danhmanu/PLC-STM32F407VET6/kicad/fab/render_bottom.png

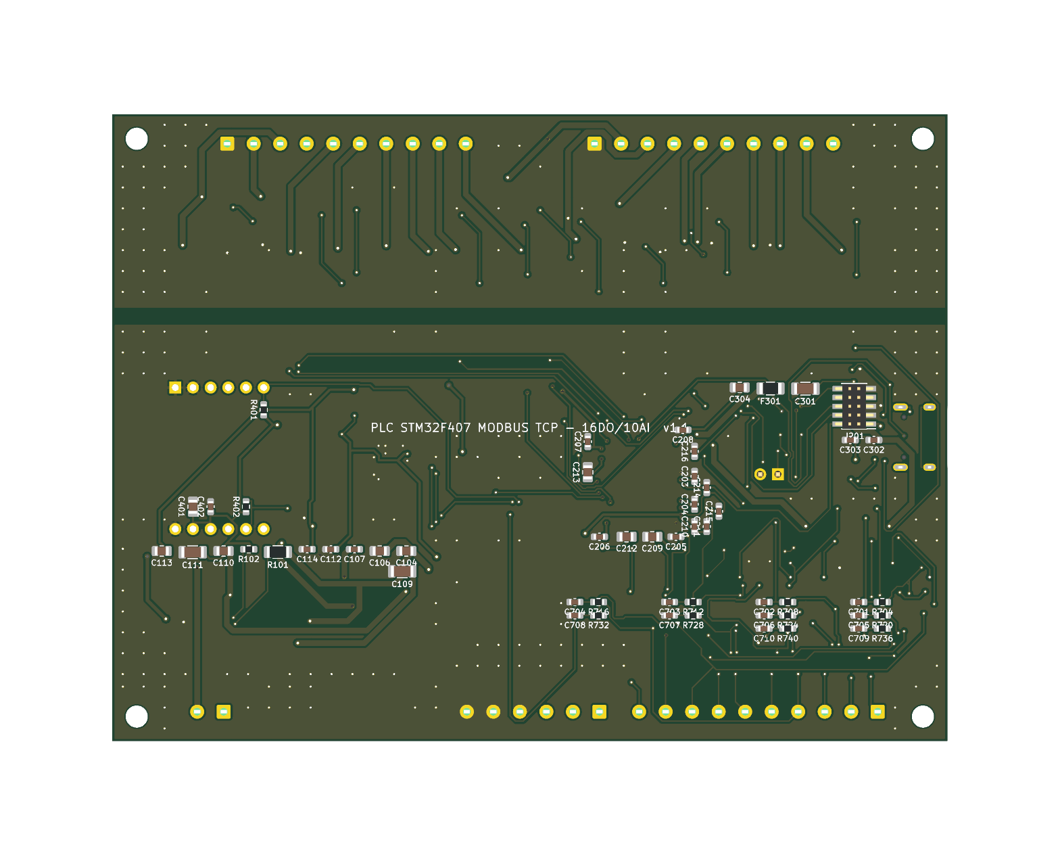
kicad/fab/render_bottom.png
