danhmanu/PLC-STM32F407VET6/kicad/BOM.csv

Ref | Value | Footprint | Qty
C101 | 47uF/50V | Capacitor_SMD:CP_Elec_6.3x7.7 | 1
C102 | 1uF/50V | Capacitor_SMD:C_1206_3216Metric | 1
C103 | 10uF/50V | Capacitor_SMD:C_1210_3225Metric | 1
C104,C106,C502 | 100nF/50V | Capacitor_SMD:C_0805_2012Metric | 3
C105 | 2.2uF/50V | Capacitor_SMD:C_1206_3216Metric | 1
C107,C112,C114,C203-C208,C211,C215,C216,C303,C402,C701-C710 | 100nF | Capacitor_SMD:C_0603_1608Metric | 24
C108,C109,C111 | 22uF | Capacitor_SMD:C_1206_3216Metric | 3
C110,C113,C304,C401 | 10uF | Capacitor_SMD:C_0805_2012Metric | 4
C201,C202 | 20pF | Capacitor_SMD:C_0603_1608Metric | 2
C209 | 4.7uF | Capacitor_SMD:C_0805_2012Metric | 1
C210,C214,C302 | 1uF | Capacitor_SMD:C_0603_1608Metric | 3
C212,C213 | 2.2uF | Capacitor_SMD:C_0805_2012Metric | 2
C301 | 4.7nF/250V | Capacitor_SMD:C_1206_3216Metric | 1
C501 | 10uF/50V | Capacitor_SMD:C_1206_3216Metric | 1
D101 | SS110 (100V/1A) | Diode_SMD:D_SMA | 1
D102 | SMBJ33CA | Diode_SMD:D_SMB | 1
D103 | PWR (green) | LED_SMD:LED_0603_1608Metric | 1
D104 | SS16 | Diode_SMD:D_SMA | 1
D105,D106 | SS14 | Diode_SMD:D_SMA | 2
D107 | 3V3 (green) | LED_SMD:LED_0603_1608Metric | 1
D201 | RUN (green) | LED_SMD:LED_0603_1608Metric | 1
D202 | ERR (red) | LED_SMD:LED_0603_1608Metric | 1
D501,D503,D505,D507,D509,D511,D513,D515,D517,D519,D521,D523,D525,D527,D529,D531 | SS16FL | Diode_SMD:D_SOD-123F | 16
D502 | Q1 | LED_SMD:LED_0603_1608Metric | 1
D504 | Q2 | LED_SMD:LED_0603_1608Metric | 1
D506 | Q3 | LED_SMD:LED_0603_1608Metric | 1
D508 | Q4 | LED_SMD:LED_0603_1608Metric | 1
D510 | Q5 | LED_SMD:LED_0603_1608Metric | 1
D512 | Q6 | LED_SMD:LED_0603_1608Metric | 1
D514 | Q7 | LED_SMD:LED_0603_1608Metric | 1
D516 | Q8 | LED_SMD:LED_0603_1608Metric | 1
D518 | Q9 | LED_SMD:LED_0603_1608Metric | 1
D520 | Q10 | LED_SMD:LED_0603_1608Metric | 1
D522 | Q11 | LED_SMD:LED_0603_1608Metric | 1
D524 | Q12 | LED_SMD:LED_0603_1608Metric | 1
D526 | Q13 | LED_SMD:LED_0603_1608Metric | 1
D528 | Q14 | LED_SMD:LED_0603_1608Metric | 1
D530 | Q15 | LED_SMD:LED_0603_1608Metric | 1
D532 | Q16 | LED_SMD:LED_0603_1608Metric | 1
D533 | SMBJ33A | Diode_SMD:D_SMB | 1
D701-D710 | SMF5.0CA | Diode_SMD:D_SOD-123F | 10
F101 | PTC MF-MSMF050-2 0.5A/60V | Fuse:Fuse_1812_4532Metric | 1
F301 | 500mA | Fuse:Fuse_1206_3216Metric | 1
F711 | MF-MSMF050-2 0.5A/60V | Fuse:Fuse_1812_4532Metric | 1
FB101 | BLM31PG601SN1 3A | Inductor_SMD:L_1206_3216Metric | 1
FB102 | 600R@100MHz | Inductor_SMD:L_0805_2012Metric | 1
J101 | 24VDC IN | TerminalBlock_Phoenix:TerminalBlock_Phoenix_MKDS-1-2-3.81_1x02_P3.81mm_Horizontal | 1
J201 | SWD | Connector_PinHeader_1.27mm:PinHeader_2x05_P1.27mm_Vertical_SMD | 1
J301 | USB-C | Connector_USB:USB_C_Receptacle_GCT_USB4105-xx-A_16P_TopMnt_Horizontal | 1
J401 | W5500 Lite module | PLC:W5500_Lite_Module | 1
J501 | OUT 1-8 | TerminalBlock_Phoenix:TerminalBlock_Phoenix_MKDS-1-10-3.81_1x10_P3.81mm_Horizontal | 1
J502 | OUT 9-16 | TerminalBlock_Phoenix:TerminalBlock_Phoenix_MKDS-1-10-3.81_1x10_P3.81mm_Horizontal | 1
J701 | AI 1-10 (4-20mA) | TerminalBlock_Phoenix:TerminalBlock_Phoenix_MKDS-1-10-3.81_1x10_P3.81mm_Horizontal | 1
J703 | AI PWR/COM | TerminalBlock_Phoenix:TerminalBlock_Phoenix_MKDS-1-6-3.81_1x06_P3.81mm_Horizontal | 1
JP301 | AUTO-BOOT | Connector_PinHeader_2.54mm:PinHeader_1x02_P2.54mm_Vertical | 1
L101 | CMC TDK ACM7060-701-2PL | Inductor_SMD:L_CommonModeChoke_TDK_ACM7060 | 1
L102 | 10uH 1A | Inductor_SMD:L_Bourns-SRN4018 | 1
Q301,Q302 | MMBT3904 | Package_TO_SOT_SMD:SOT-23 | 2
Q303 | MMBT3906 | Package_TO_SOT_SMD:SOT-23 | 1
Q501-Q516 | DMN6075S | Package_TO_SOT_SMD:SOT-23 | 16
R101 | 4.7k | Resistor_SMD:R_1206_3216Metric | 1
R102,R203,R204,R308 | 1k | Resistor_SMD:R_0603_1608Metric | 4
R201,R202,R304-R307,R401,R402,R502-R504,R506-R508,R510-R512,R514-R516,R518-R520,R522-R524,R526-R528,R530-R532,R534-R536,R538-R540,R542-R544,R546-R548,R550-R552,R554-R556,R558-R560,R562-R564 | 10k | Resistor_SMD:R_0603_1608Metric | 56
R301,R302 | 5.1k | Resistor_SMD:R_0603_1608Metric | 2
R303 | 1M | Resistor_SMD:R_0603_1608Metric | 1
R501,R505,R509,R513,R517,R521,R525,R529,R533,R537,R541,R545,R549,R553,R557,R561 | 470 | Resistor_SMD:R_0603_1608Metric | 16
R701,R705,R709,R713,R717,R721,R725,R729,R733,R737 | 120 0.1% 25ppm | Resistor_SMD:R_1206_3216Metric | 10
R704,R708,R712,R716,R720,R724,R728,R732,R736,R740 | 4.7k | Resistor_SMD:R_0603_1608Metric | 10
SW201 | RESET | Button_Switch_SMD:SW_SPST_PTS810 | 1
SW202 | BOOT | Button_Switch_SMD:SW_SPST_PTS810 | 1
U101 | LMR16006YQ5 | Package_TO_SOT_SMD:SOT-23-6 | 1
U102 | AMS1117-3.3 | Package_TO_SOT_SMD:SOT-223-3_TabPin2 | 1
U200 | STM32F407VET6 | Package_QFP:LQFP-100_14x14mm_P0.5mm | 1
U201 | REF3030 | Package_TO_SOT_SMD:SOT-23 | 1
U301 | USBLC6-2SC6 | Package_TO_SOT_SMD:SOT-23-6 | 1
U302 | CH340C | Package_SO:SOIC-16_3.9x9.9mm_P1.27mm | 1
U501-U516 | PC817 (SMD) | Package_DIP:SMDIP-4_W9.53mm | 16
Y201 | 8MHz 20pF | Crystal:Crystal_SMD_3225-4Pin_3.2x2.5mm | 1
