danhmanu/PLC-STM32F407VET6/kicad/PLC_STM32_Modbus.pdf

1 | 2 | 3 | 4 | 5 | 6 | 7 | 8

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
Size: A3 | Rev: 1.0 | F Date: 2026-10-14
KiCad E.D.A. 10.0.6 | Id: 1/7

# Title: PLC STM32F407 Modbus TCP - 16DO / 10AI

## File: PLC_STM32_Modbus.kicad_sch

## Sheet: /

## PLC STM32F407 + W5500 Modbus TCP

## Sheet: Root

## 16 ngo ra transistor File: outputs.kicad_sch

## Nguon 24VDC

## File: power.kicad_sch

## MCU STM32F407VET6

File: mcu.kicad_sch | USB nap code
File: usb.kicad_sch | Ethernet File: comm.kicad_sch 10 ngo vao analog

## File: analog.kicad_sch

# PLC STM32F407VET6 + W5500 : Modbus TCP (LAN), nap code qua USB-C (CH340C)

# TỔNG QUAN HỆ THỐNG – PLC STM32F407 + W5500 (Modbus TCP)

- Nguồn 24VDC → bảo vệ (PTC, chống ngược, TVS) + lọc nhiễu → buck 5V → LDO 3.3V; +3.3VA riêng cho ADC. • MCU STM32F407VET6 (168MHz): 16 ngõ ra DO1–DO16, 10 ngõ vào 4–20mA (ADC 12-bit, VREF 3.000V), SPI2 → W5500. • Ethernet: module W5500 Lite (có sẵn RJ45): Modbus TCP cổng 502, tối đa 8 kết nối. Coil 00001–00016 = DO1–DO16; Input Register 30001–30010 = AI1–AI10. • USB-C + CH340C: nạp chương trình qua bootloader UART (tự vào boot bằng DTR/RTS), cổng debug. • 16 ngõ ra: opto PC817 (cách ly 5kV) + MOSFET 60V/2.5A, kiểu sink, nguồn tải V+/COM riêng 12–30V. • 10 ngõ vào 4–20mA: TVS + shunt 120Ω + lọc RC; J703 cấp 24V (PTC 0.5A) nuôi cảm biến 2 dây. • Ghi chú chi tiết (tác dụng, cách tính giá trị) đặt ngay cạnh từng linh kiện ở các trang con.

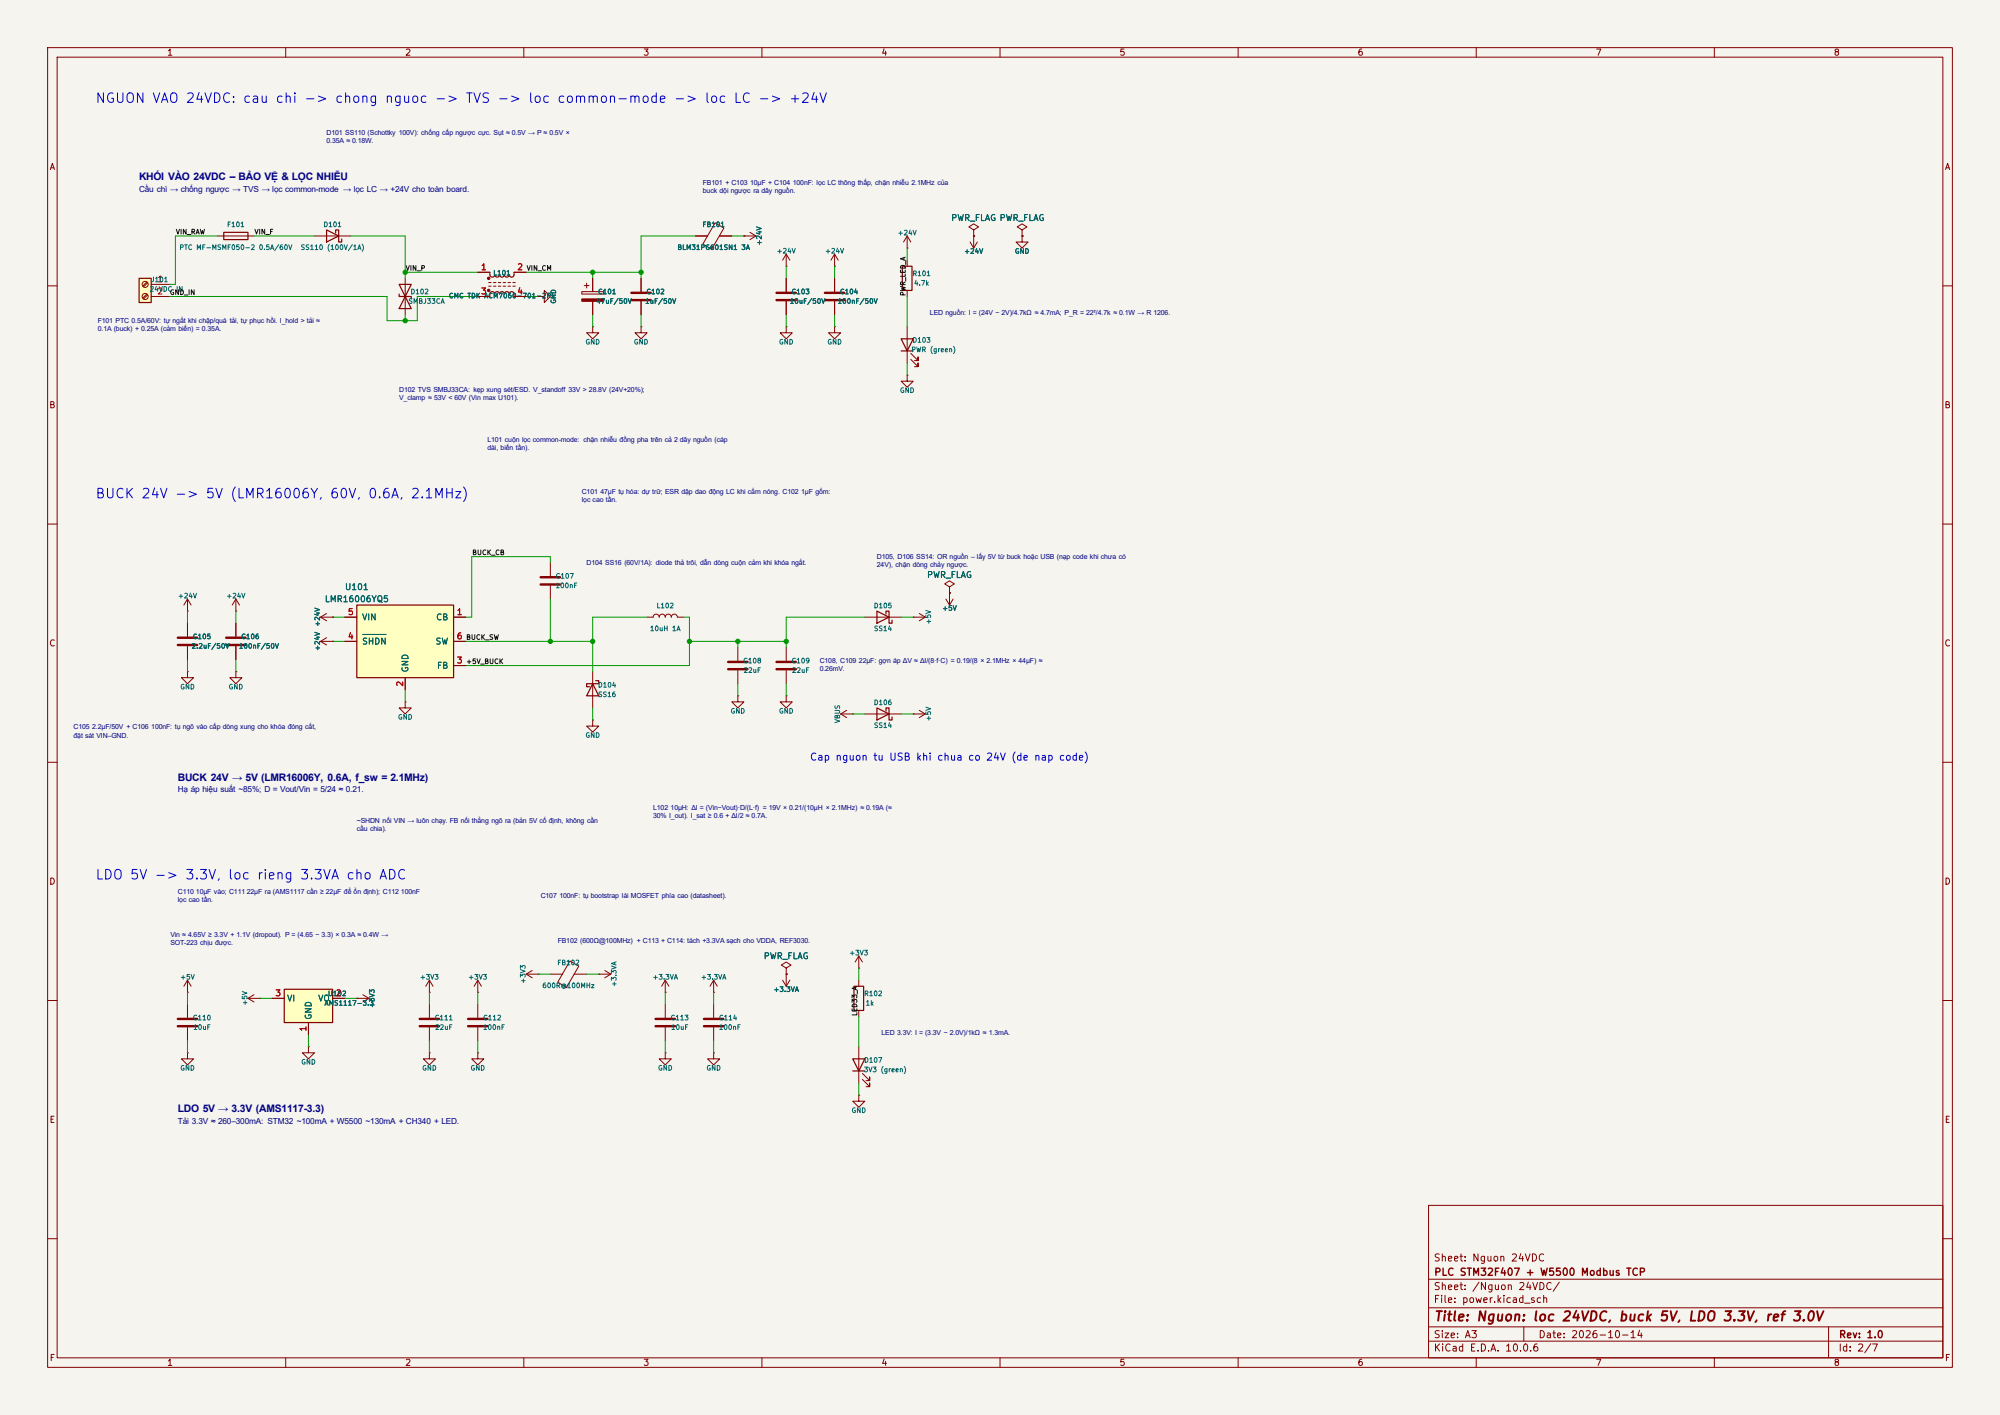
[picture p3: page 2]

NGUON VAO 24VDC: cau chi -> chong nguoc -> TVS -> loc common-mode -> loc LC -> +24V
VIN_RAW

0.35A ≈ 0.18W. F101 PTC 0.5A/60V: tự ngắt khi chập/quá tải, tự phục hồi. I_hold > tải ≈ 0.1A (buck) + 0.25A (cảm biến) = 0.35A.

D101 SS110 (Schottky 100V): chống cấp ngược cực. Sụt ≈ 0.5V → P ≈ 0.5V ×

Cầu chì → chống ngược → TVS → lọc common-mode → lọc LC → +24V cho toàn board. KHỐI VÀO 24VDC – BẢO VỆ & LỌC NHIỄU

FB101 + C103 10µF + C104 100nF: lọc LC thông thấp, chặn nhiễu 2.1MHz của

L101 cuộn lọc common-mode: chặn nhiễu đồng pha trên cả 2 dây nguồn (cáp
dài, biến tần).

lọc cao tần. BUCK 24V -> 5V (LMR16006Y, 60V, 0.6A, 2.1MHz)
lọc cao tần. LDO 5V -> 3.3V, loc rieng 3.3VA cho ADC

L102 10µH: ΔI = (Vin−Vout)·D/(L·f) = 19V × 0.21/(10µH × 2.1MHz) ≈ 0.19A (≈ 30% I_out). I_sat ≥ 0.6 + ΔI/2 ≈ 0.7A.

~SHDN nối VIN → luôn chạy. FB nối thẳng ngõ ra (bản 5V cố định, không cần
cầu chia).

Sheet: Nguon 24VDC
PLC STM32F407 + W5500 Modbus TCP
Sheet: /Nguon 24VDC/
File: power.kicad_sch
Title: Nguon: loc 24VDC, buck 5V, LDO 3.3V, ref 3.0V

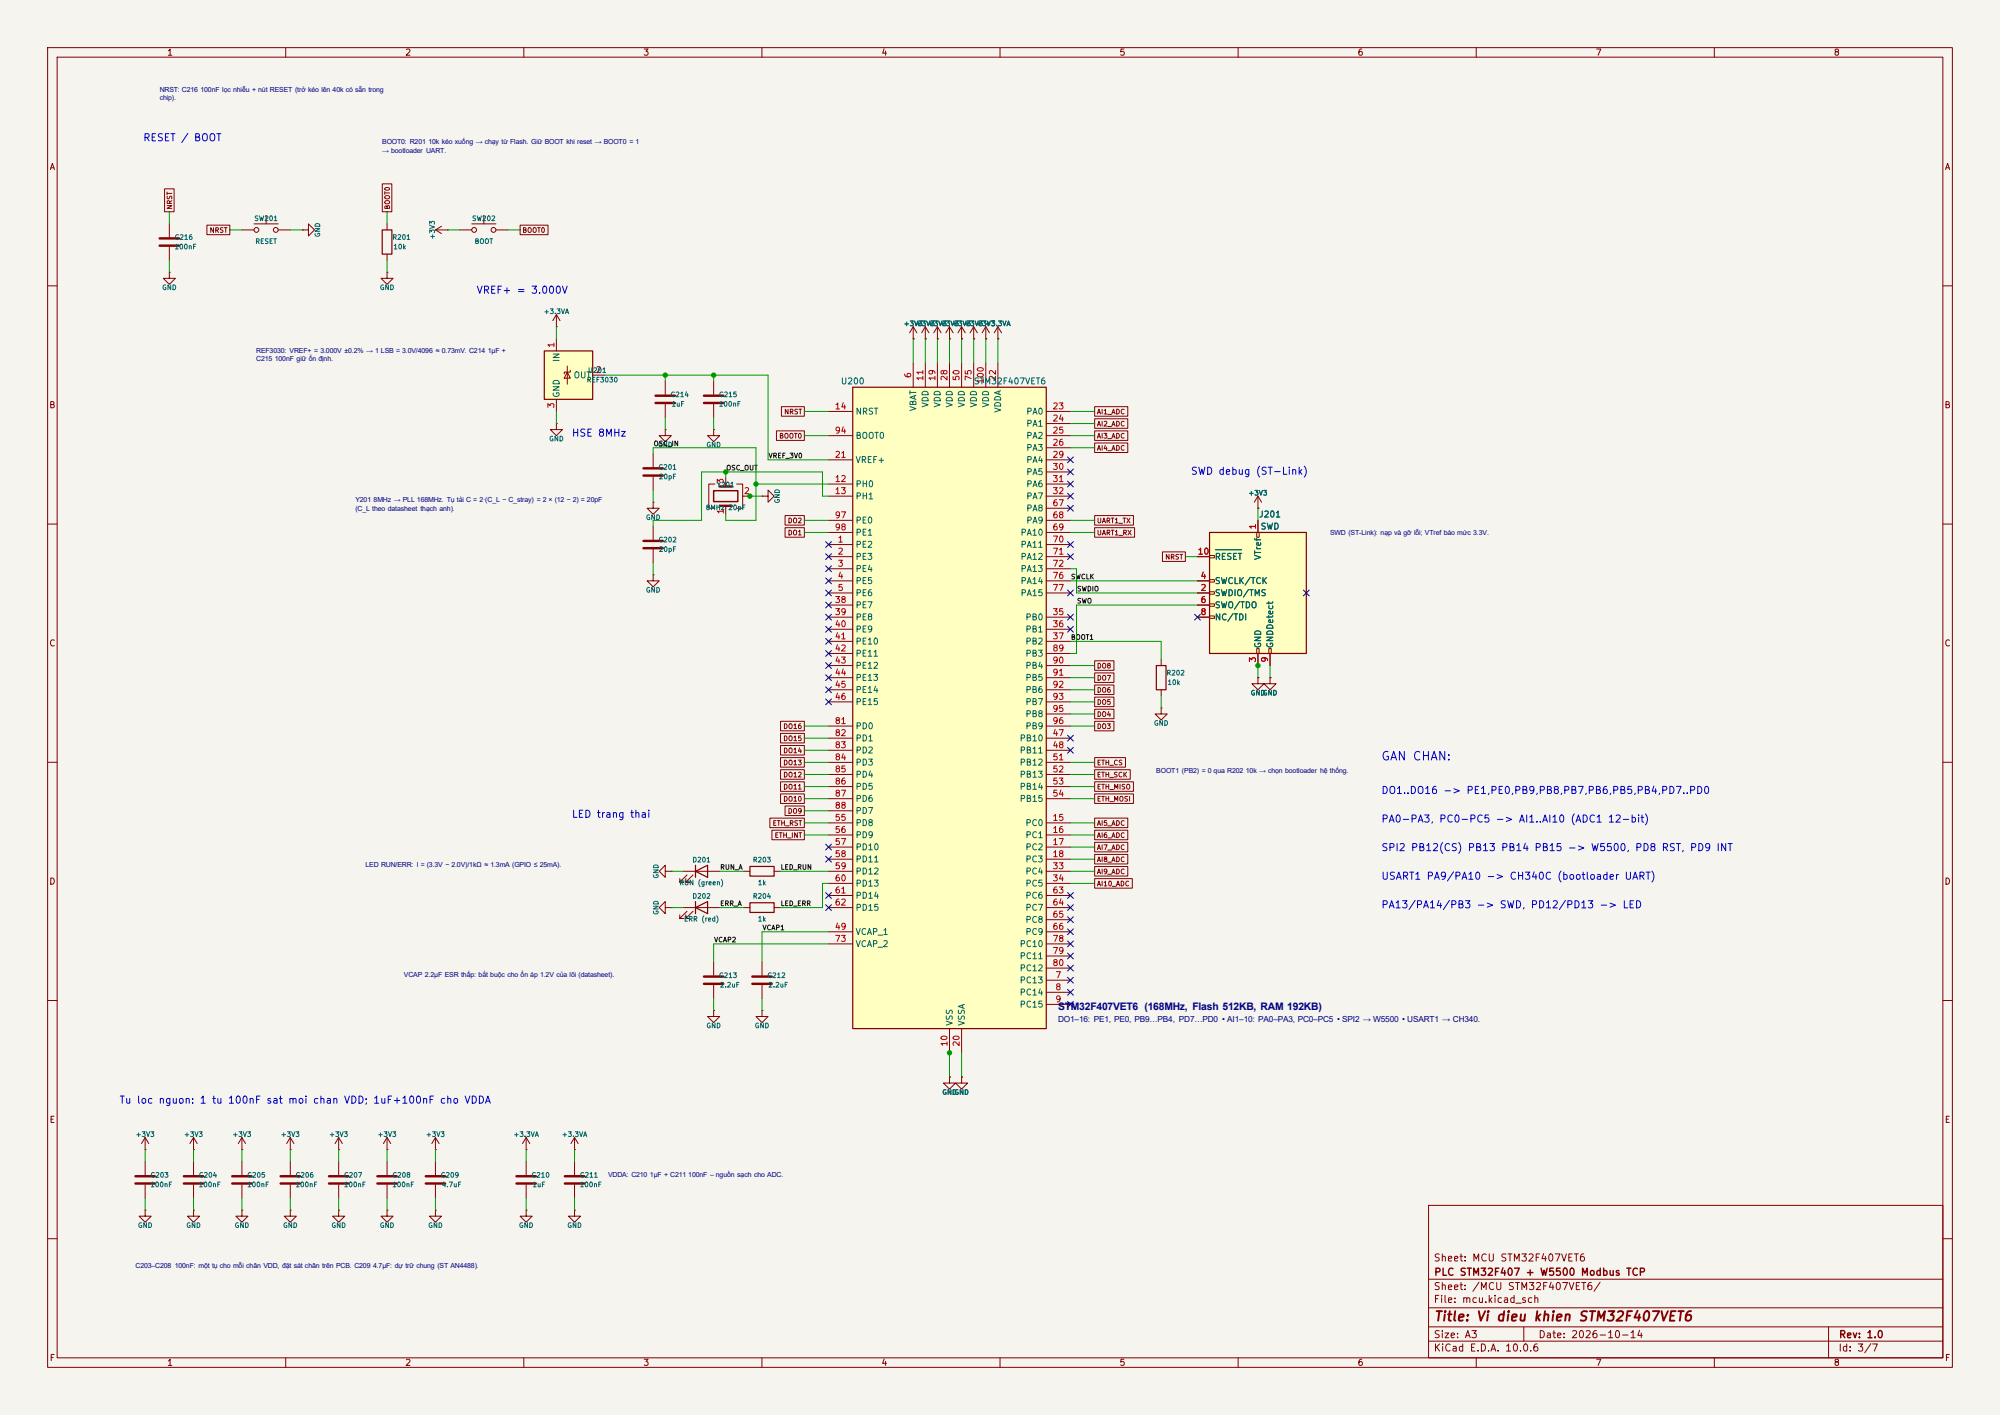
[picture p4: page 3]

NRST: C216 100nF lọc nhiễu + nút RESET (trở kéo lên 40k có sẵn trong

BOOT0: R201 10k kéo xuống → chạy từ Flash. Giữ BOOT khi reset → BOOT0 = 1 → bootloader UART.

Tu loc nguon: 1 tu 100nF sat moi chan VDD; 1uF+100nF cho VDDA

Sheet: MCU STM32F407VET6
PLC STM32F407 + W5500 Modbus TCP
Sheet: /MCU STM32F407VET6/
File: mcu.kicad_sch
Title: Vi dieu khien STM32F407VET6

C203–C208 100nF: một tụ cho mỗi chân VDD, đặt sát chân trên PCB. C209 4.7µF: dự trữ chung (ST AN4488).

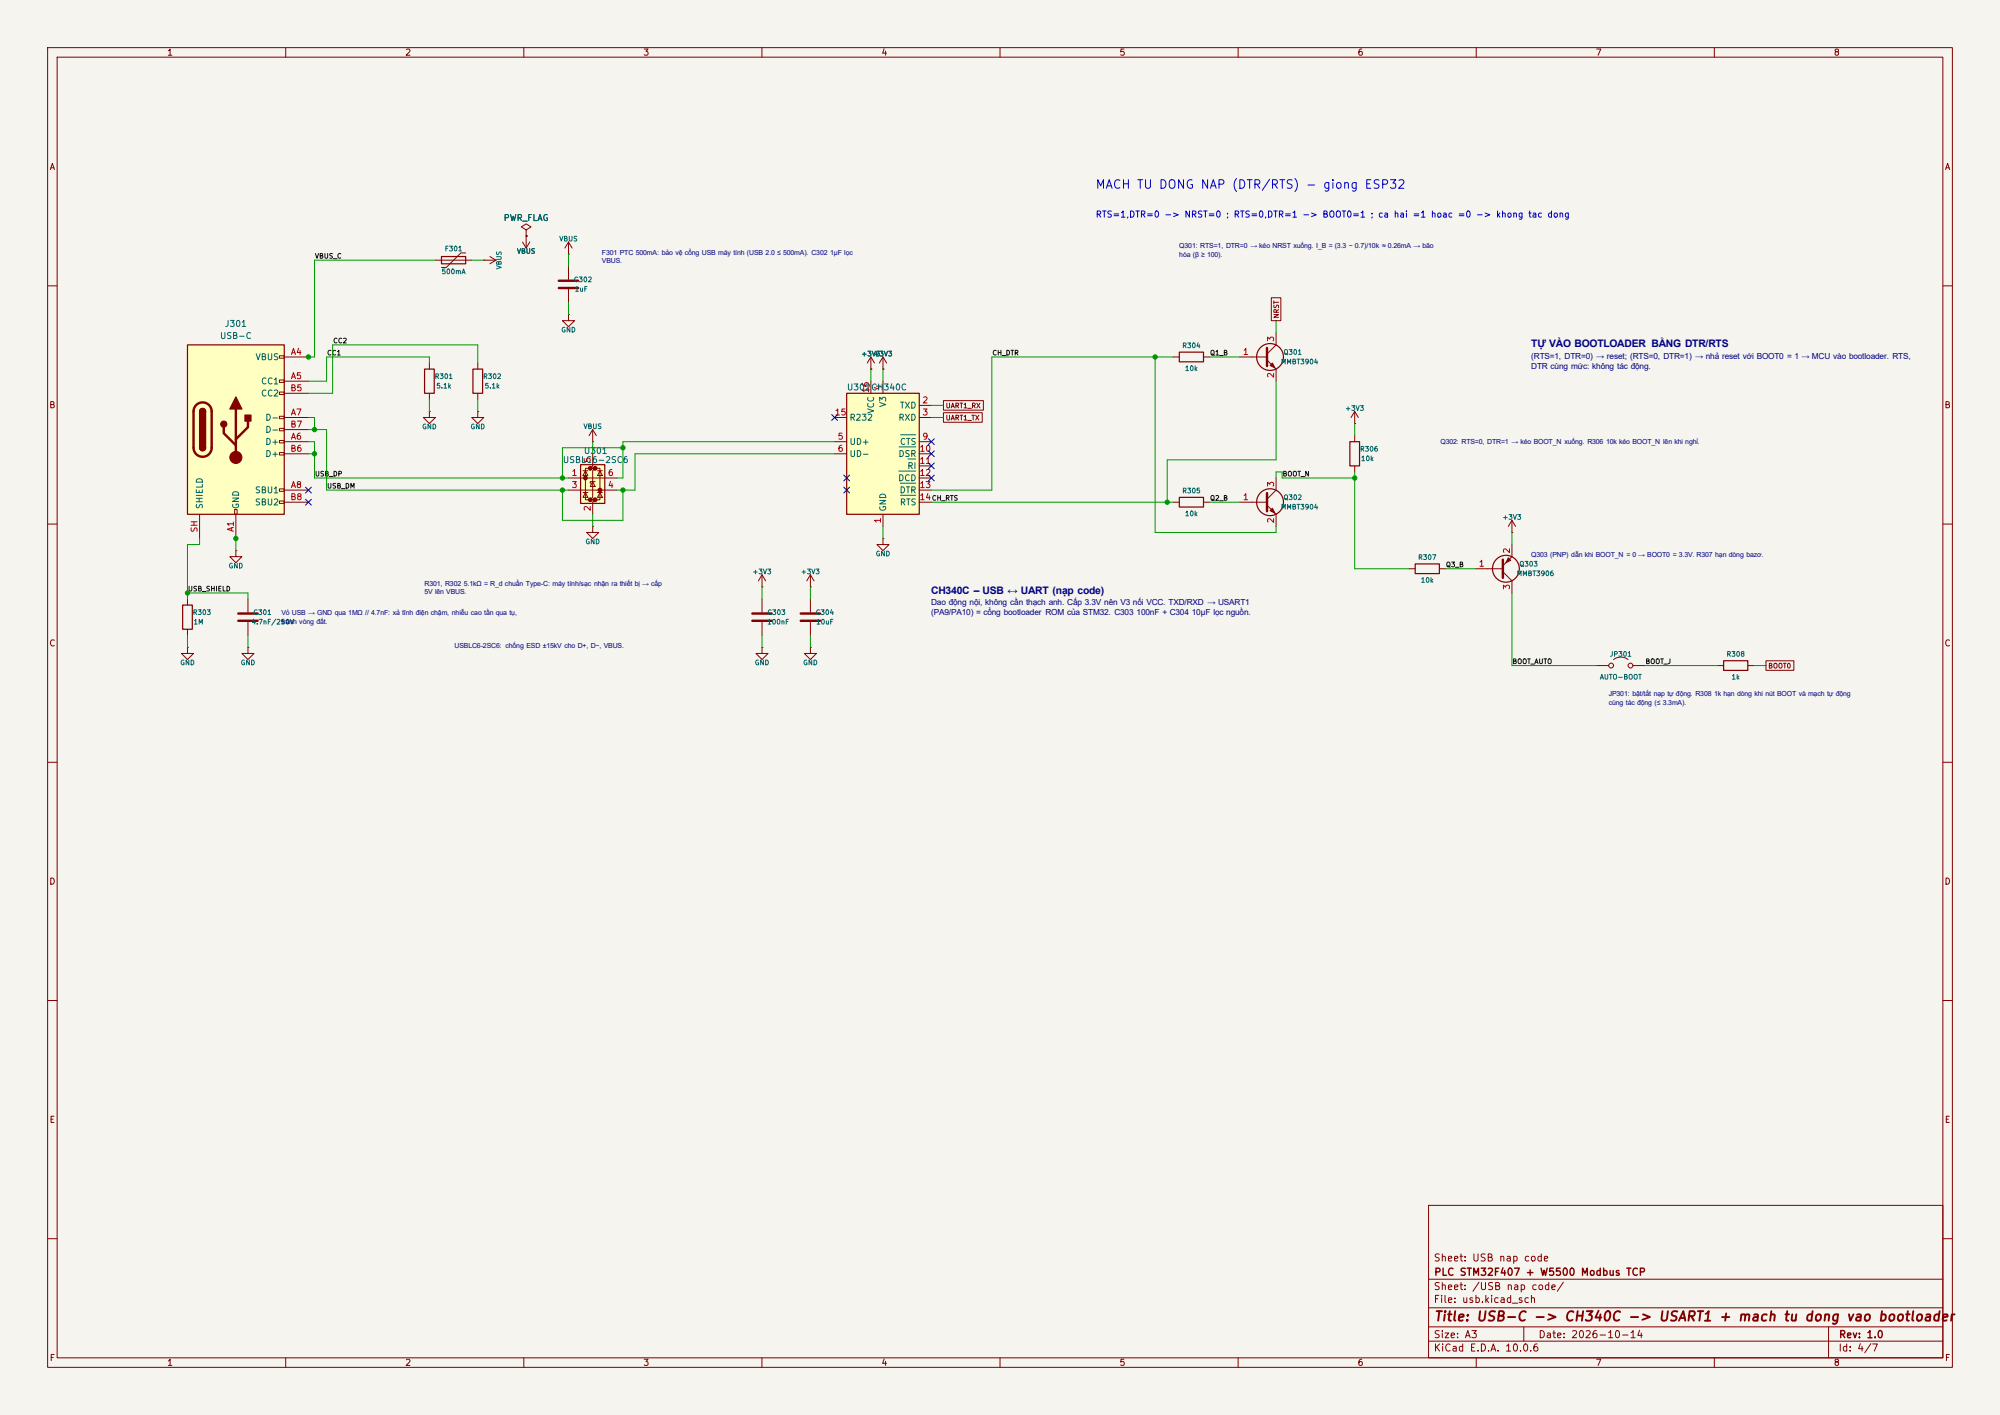
[picture p5: page 4]

cùng tác động (≤ 3.3mA). MACH TU DONG NAP (DTR/RTS) - giong ESP32

(RTS=1, DTR=0) → reset; (RTS=0, DTR=1) → nhả reset với BOOT0 = 1 → MCU vào bootloader. RTS, DTR cùng mức: không tác động. F301 PTC 500mA: bảo vệ cổng USB máy tính (USB 2.0 ≤ 500mA). C302 1µF lọc VBUS. R301, R302 5.1kΩ = R_d chuẩn Type-C: máy tính/sạc nhận ra thiết bị → cấp

hòa (β ≥ 100). Dao động nội, không cần thạch anh. Cấp 3.3V nên V3 nối VCC. TXD/RXD → USART1

TỰ VÀO BOOTLOADER BẰNG DTR/RTS

4 UD+ 5 UD- 6 CTS 9 DSR 10 RI 11 DCD 12 DTR 13 RTS 14 R232 15 VCC U30216CH340C

Sheet: USB nap code GND

Q303 (PNP) dẫn khi BOOT_N = 0 → BOOT0 = 3.3V. R307 hạn dòng bazơ. Vỏ USB → GND qua 1MΩ // 4.7nF: xả tĩnh điện chậm, nhiễu cao tần qua tụ,

(PA9/PA10) = cổng bootloader ROM của STM32. C303 100nF + C304 10µF lọc nguồn.

JP301: bật/tắt nạp tự động. R308 1k hạn dòng khi nút BOOT và mạch tự động

PLC STM32F407 + W5500 Modbus TCP
Sheet: /USB nap code/
File: usb.kicad_sch
Title: USB-C -> CH340C -> USART1 + mach tu dong vao bootloader

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
# Title: Ethernet - module W5500 Lite (Modbus TCP)

File: comm.kicad_sch

## Sheet: /Ethernet/

## PLC STM32F407 + W5500 Modbus TCP

## Sheet: Ethernet

## W5500 Lite

RJ45 GND 1 | GND 2 | MOSI 3
SCLK 4 | CS 5
INT 6 | GND | 7
3V3 | | | 8
3V3 | 9 RST | 11 MISO | 12
J401 W5500 Lite module GND +3V3 | +3V3 R401
10k | GND

R402

10k | +3V3GND | GND +3V3C401
10uF | GND C402
100nF +3V3 ETH_RST | ETH_RST ETH_MOSI ETH_INT | ETH_SCK

ETH_CS
ETH_INT | ETH_MISO

Trên module có sẵn: chip W5500, thạch anh 25MHz, điện trở phối hợp 49.9Ω, tụ TOCAP/1V2O và jack RJ45 có biến áp cách ly – board chính chỉ cần cấp 3.3V và nối SPI. 8 socket phần cứng = tối đa 8 kết nối Modbus TCP đồng thời (cổng 502). Giao tiếp MCU: SPI2 – PB12 = CS, PB13 = SCLK, PB14 = MISO, PB15 = MOSI (≤ 21MHz), PD8 = RST, PD9 = INT. Lắp: 2 hàng socket cái 1×6 bước 2.54mm, cách nhau 20.32mm; RJ45 hướng ra mép board. Hàn header vào module với chân

hướng xuống (linh kiện và RJ45 ở mặt trên).

# ETHERNET: module W5500 Lite (W5500 + RJ45 co bien ap) cam vao 2 hang socket 1x6

## MODULE W5500 LITE – ETHERNET 10/100 + TCP/IP PHẦN CỨNG

C401 10µF + C402 100nF: lọc nguồn 3.3V cho module, đặt sát chân 3V3 của socket. W5500 hút ~130mA dạng xung khi phát → cần tụ dự trữ gần module. R401, R402 10k kéo lên INT, RST: giữ mức 1 khi MCU chưa khởi động (module
không reset ngẫu nhiên). INT tích cực mức thấp. | GND | +3V3GND

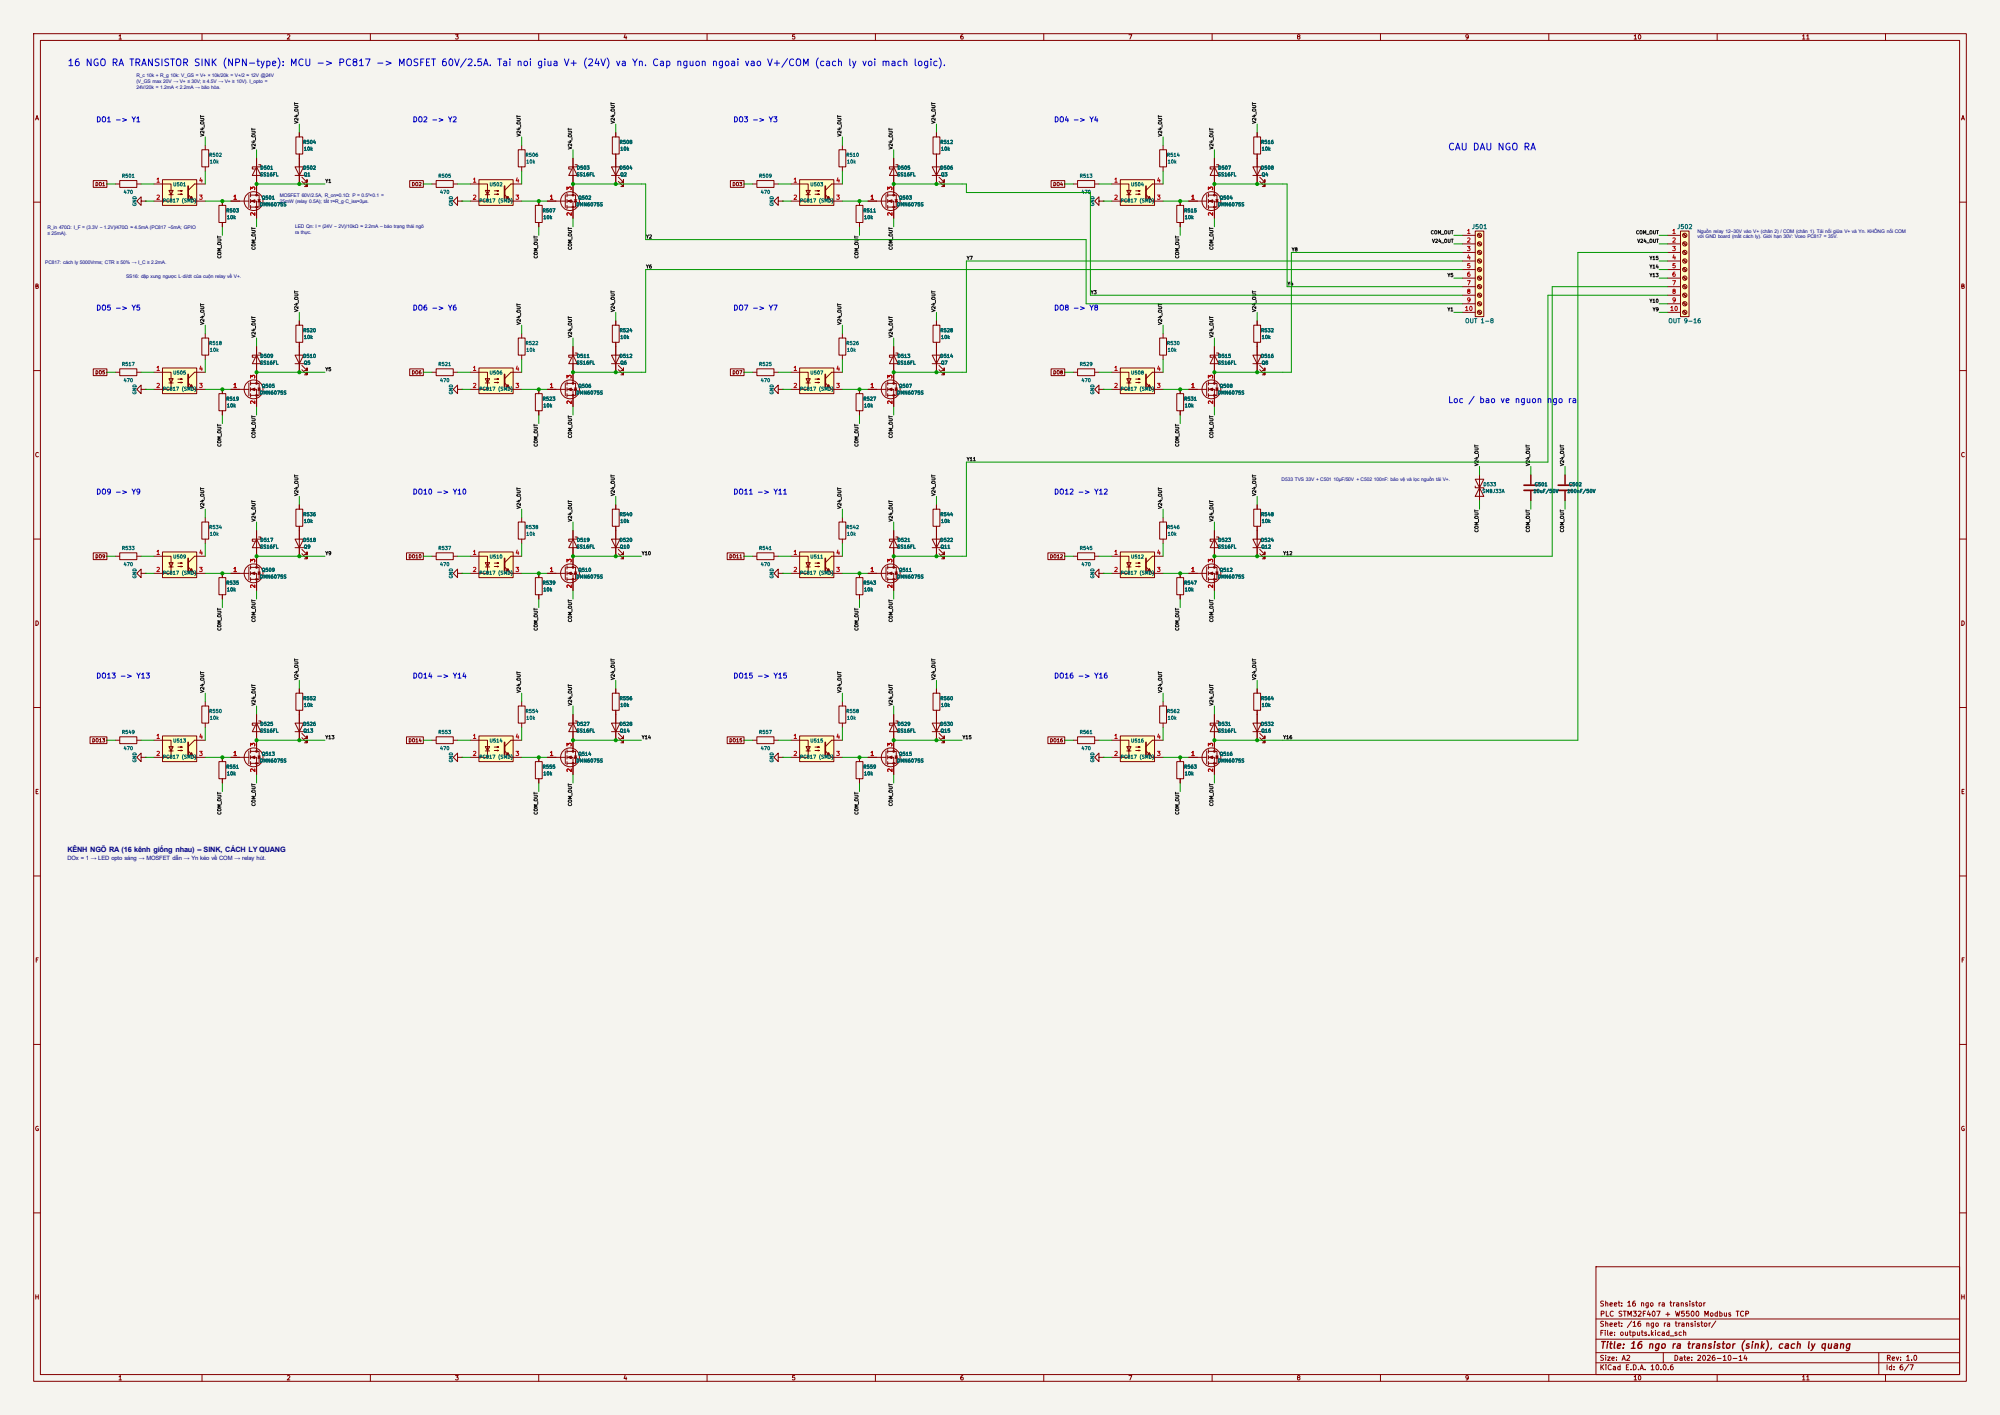
[picture p6: page 6]

với GND board (mất cách ly). Giới hạn 30V: Vceo PC817 = 35V. 16 NGO RA TRANSISTOR SINK (NPN-type): MCU -> PC817 -> MOSFET 60V/2.5A. Tai noi giua V+ (24V) va Yn. Cap nguon ngoai vao V+/COM (cach ly voi mach logic). R_in 470Ω: I_F = (3.3V − 1.2V)/470Ω ≈ 4.5mA (PC817 ~5mA; GPIO

ra thực. SS16: dập xung ngược L·di/dt của cuộn relay về V+. R_c 10k + R_g 10k: V_GS = V+ × 10k/20k = V+/2 ≈ 12V @24V
(V_GS max 20V → V+ ≤ 30V; ≥ 4.5V → V+ ≥ 10V). I_opto =
24V/20k = 1.2mA < 2.2mA → bão hòa.

CAU DAU NGO RA

LED Qn: I = (24V − 2V)/10kΩ ≈ 2.2mA – báo trạng thái ngõ

Nguồn relay 12–30V vào V+ (chân 2) / COM (chân 1). Tải nối giữa V+ và Yn. KHÔNG nối COM

Sheet: 16 ngo ra transistor GND GND

Loc / bao ve nguon ngo ra

D533 TVS 33V + C501 10µF/50V + C502 100nF: bảo vệ và lọc nguồn tải V+.

KÊNH NGÕ RA (16 kênh giống nhau) – SINK, CÁCH LY QUANG
DOx = 1 → LED opto sáng → MOSFET dẫn → Yn kéo về COM → relay hút.

PLC STM32F407 + W5500 Modbus TCP
Sheet: /16 ngo ra transistor/
File: outputs.kicad_sch
Title: 16 ngo ra transistor (sink), cach ly quang

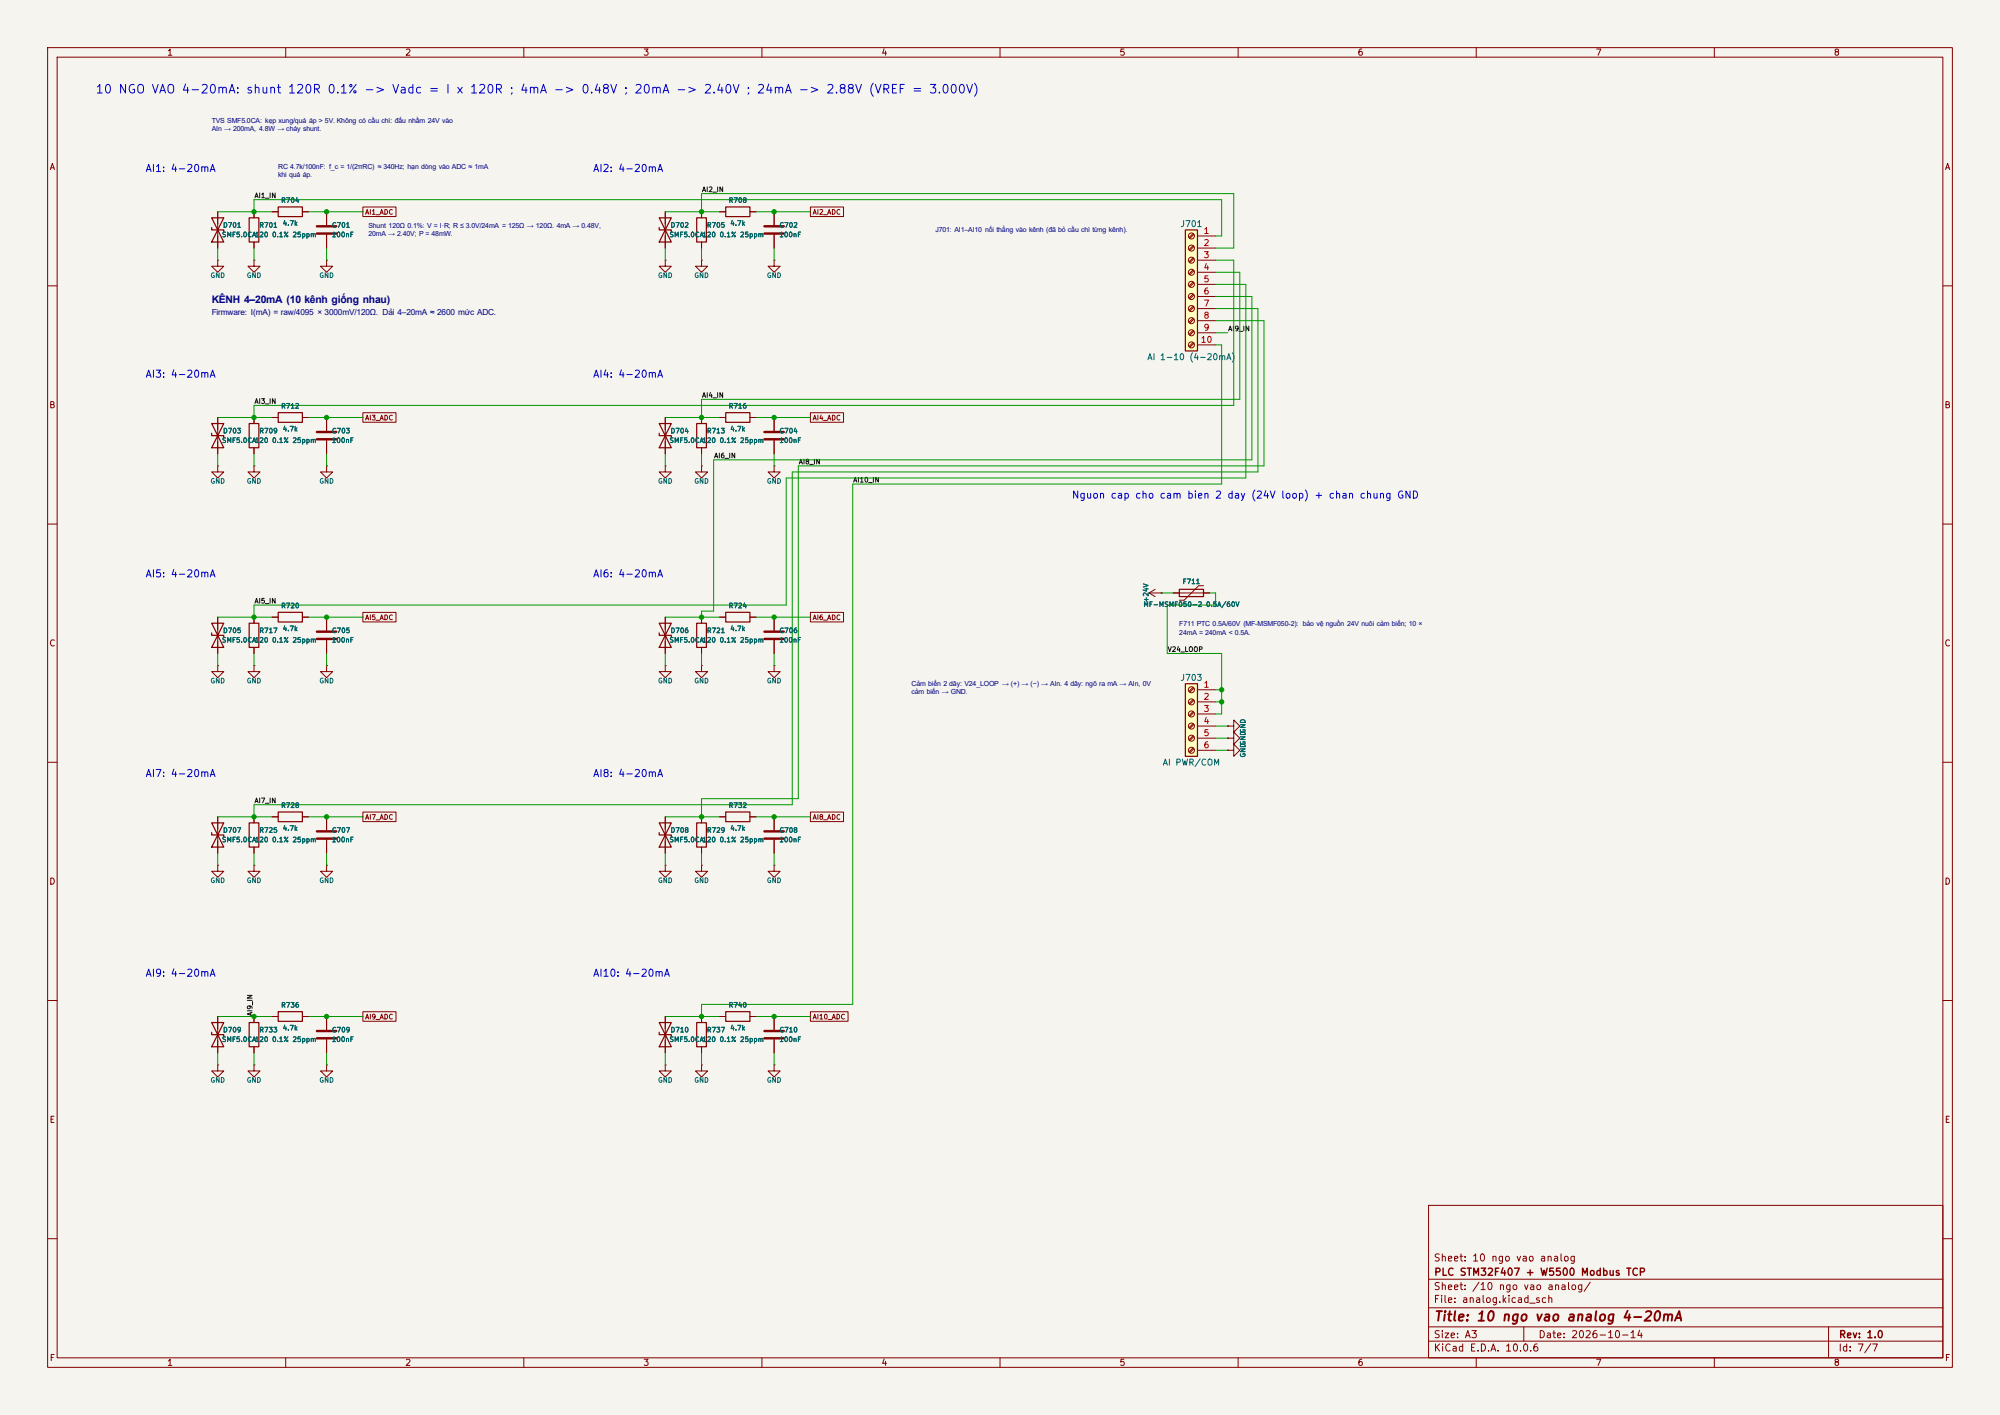
[picture p7: page 7]

10 NGO VAO 4-20mA: shunt 120R 0.1% -> Vadc = I x 120R ; 4mA -> 0.48V ; 20mA -> 2.40V ; 24mA -> 2.88V (VREF = 3.000V)

Shunt 120Ω 0.1%: V = I·R; R ≤ 3.0V/24mA = 125Ω → 120Ω. 4mA → 0.48V, 20mA → 2.40V; P = 48mW. RC 4.7k/100nF: f_c = 1/(2πRC) ≈ 340Hz; hạn dòng vào ADC ≈ 1mA

J701: AI1–AI10 nối thẳng vào kênh (đã bỏ cầu chì từng kênh). AI8: 4-20mA

Sheet: 10 ngo vao analog
PLC STM32F407 + W5500 Modbus TCP
Sheet: /10 ngo vao analog/
File: analog.kicad_sch
Title: 10 ngo vao analog 4-20mA
