danhmanu/PLC-STM32F407VET6/kicad/fab/PCB_bottom.pdf

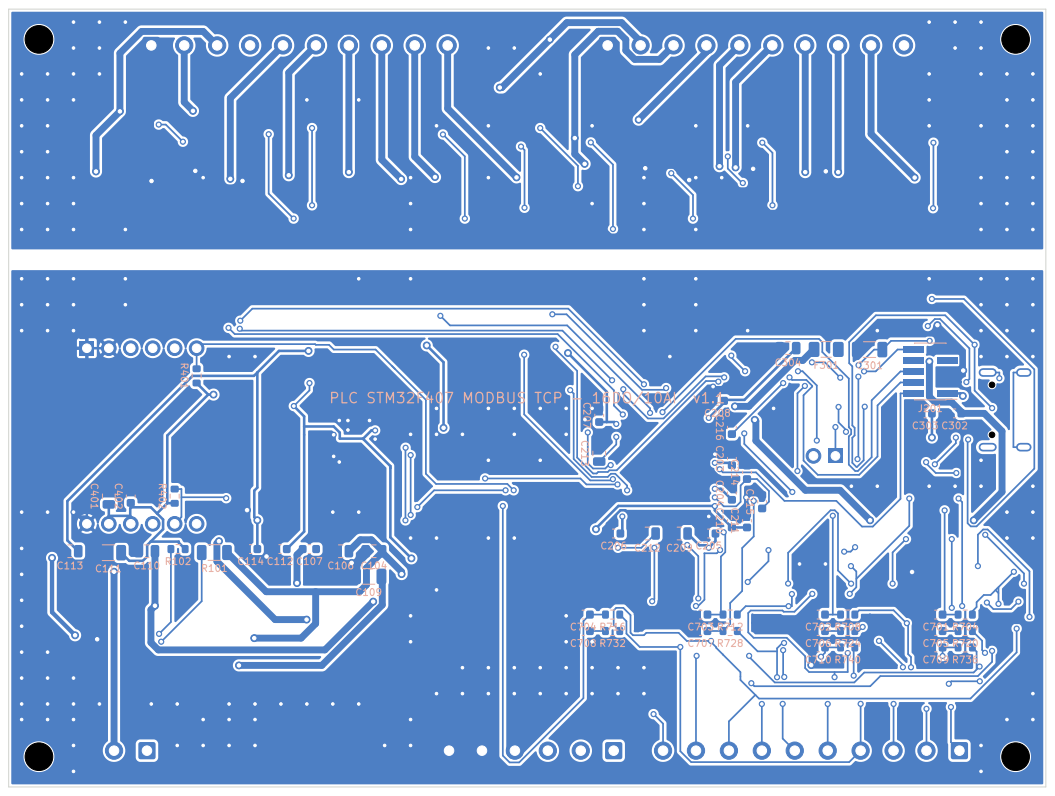
[picture p8: page 1]
