danhmanu/PLC-STM32F407VET6/kicad/fab/PCB_top.pdf

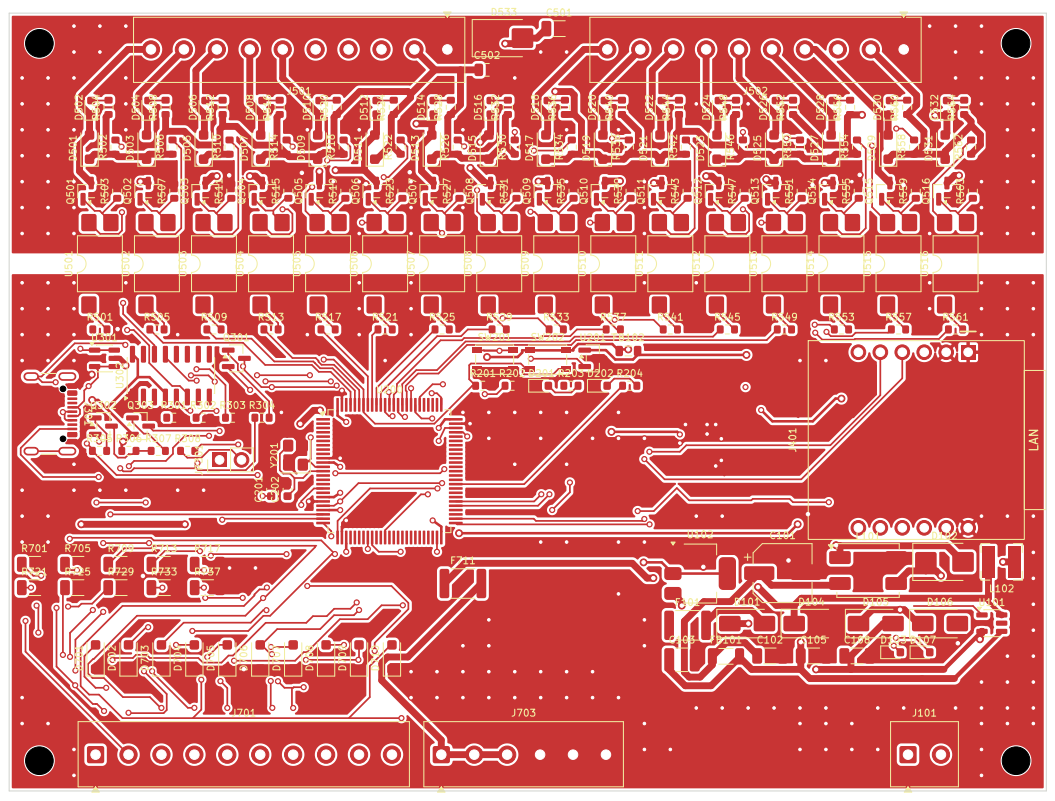
[picture p9: page 1]
