danhmanu/PLC-STM32F407VET6/(list of files, drawings)

Other design files:
kicad/freerouting.dsn
kicad/temp-freerouting.dsn
