danhmanu/PLC-STM32F407VET6/kicad/PLC_STM32_Modbus.kicad_pcb

## KiCad design kicad/PLC_STM32_Modbus.kicad_pcb (2026-10-28)

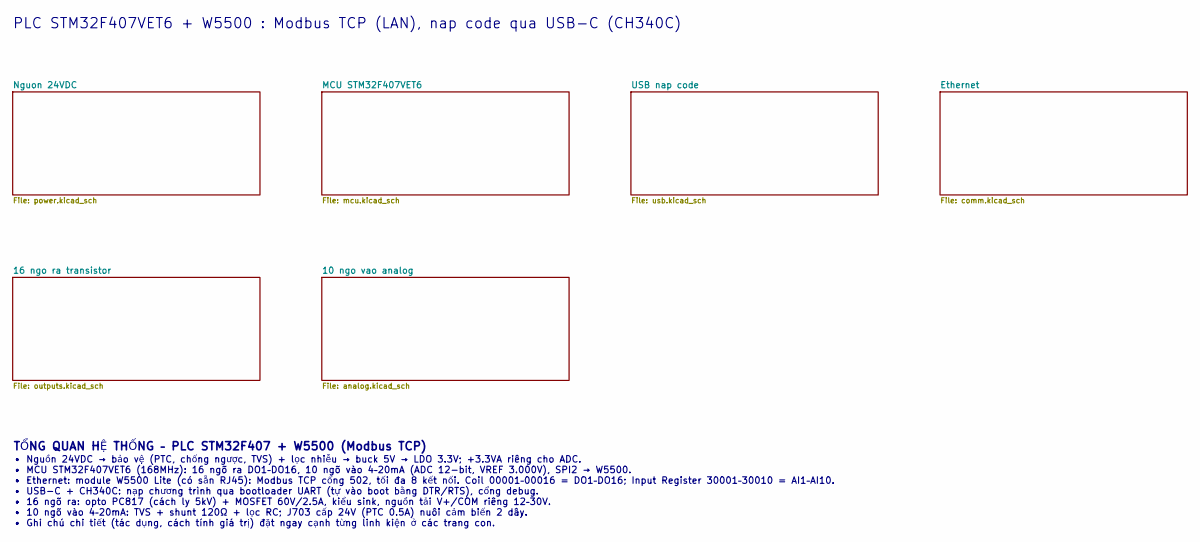
[picture p10: schematic PLC_STM32_Modbus.kicad_sch, PLC STM32F407 Modbus TCP - 16DO / 10AI]

Notes on the sheet:
PLC STM32F407VET6 + W5500 : Modbus TCP (LAN), nap code qua USB-C (CH340C)
TỔNG QUAN HỆ THỐNG – PLC STM32F407 + W5500 (Modbus TCP)
• Nguồn 24VDC → bảo vệ (PTC, chống ngược, TVS) + lọc nhiễu → buck 5V → LDO 3.3V; +3.3VA riêng cho ADC. • MCU STM32F407VET6 (168MHz): 16 ngõ ra DO1–DO16, 10 ngõ vào 4–20mA (ADC 12-bit, VREF 3.000V), SPI2 → W5500. • Ethernet: module W5500 Lite (có sẵn RJ45): Modbus TCP cổng 502, tối đa 8 kết nối. Coi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

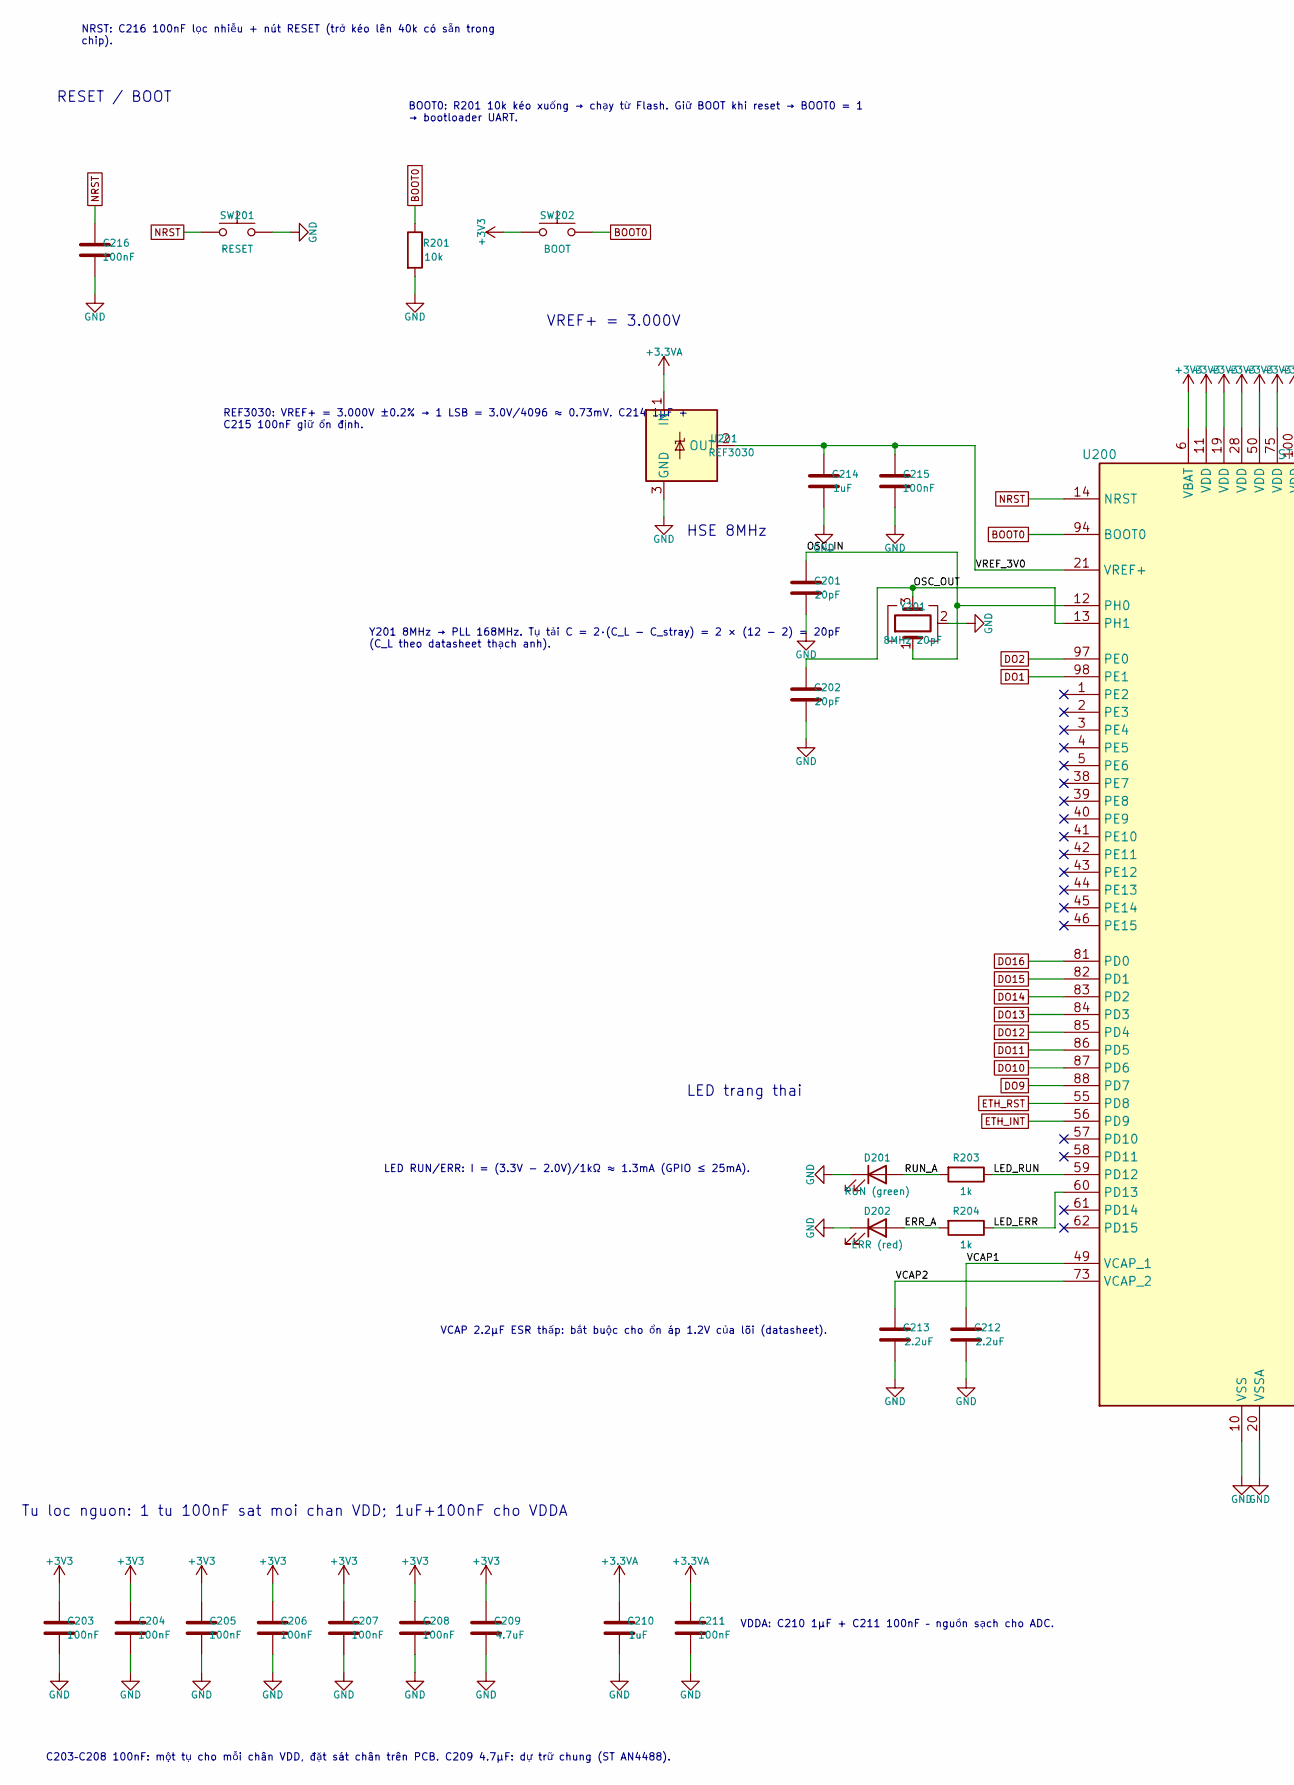
[picture p11: schematic mcu.kicad_sch, Vi dieu khien STM32F407VET6, part in row 1, column 1]

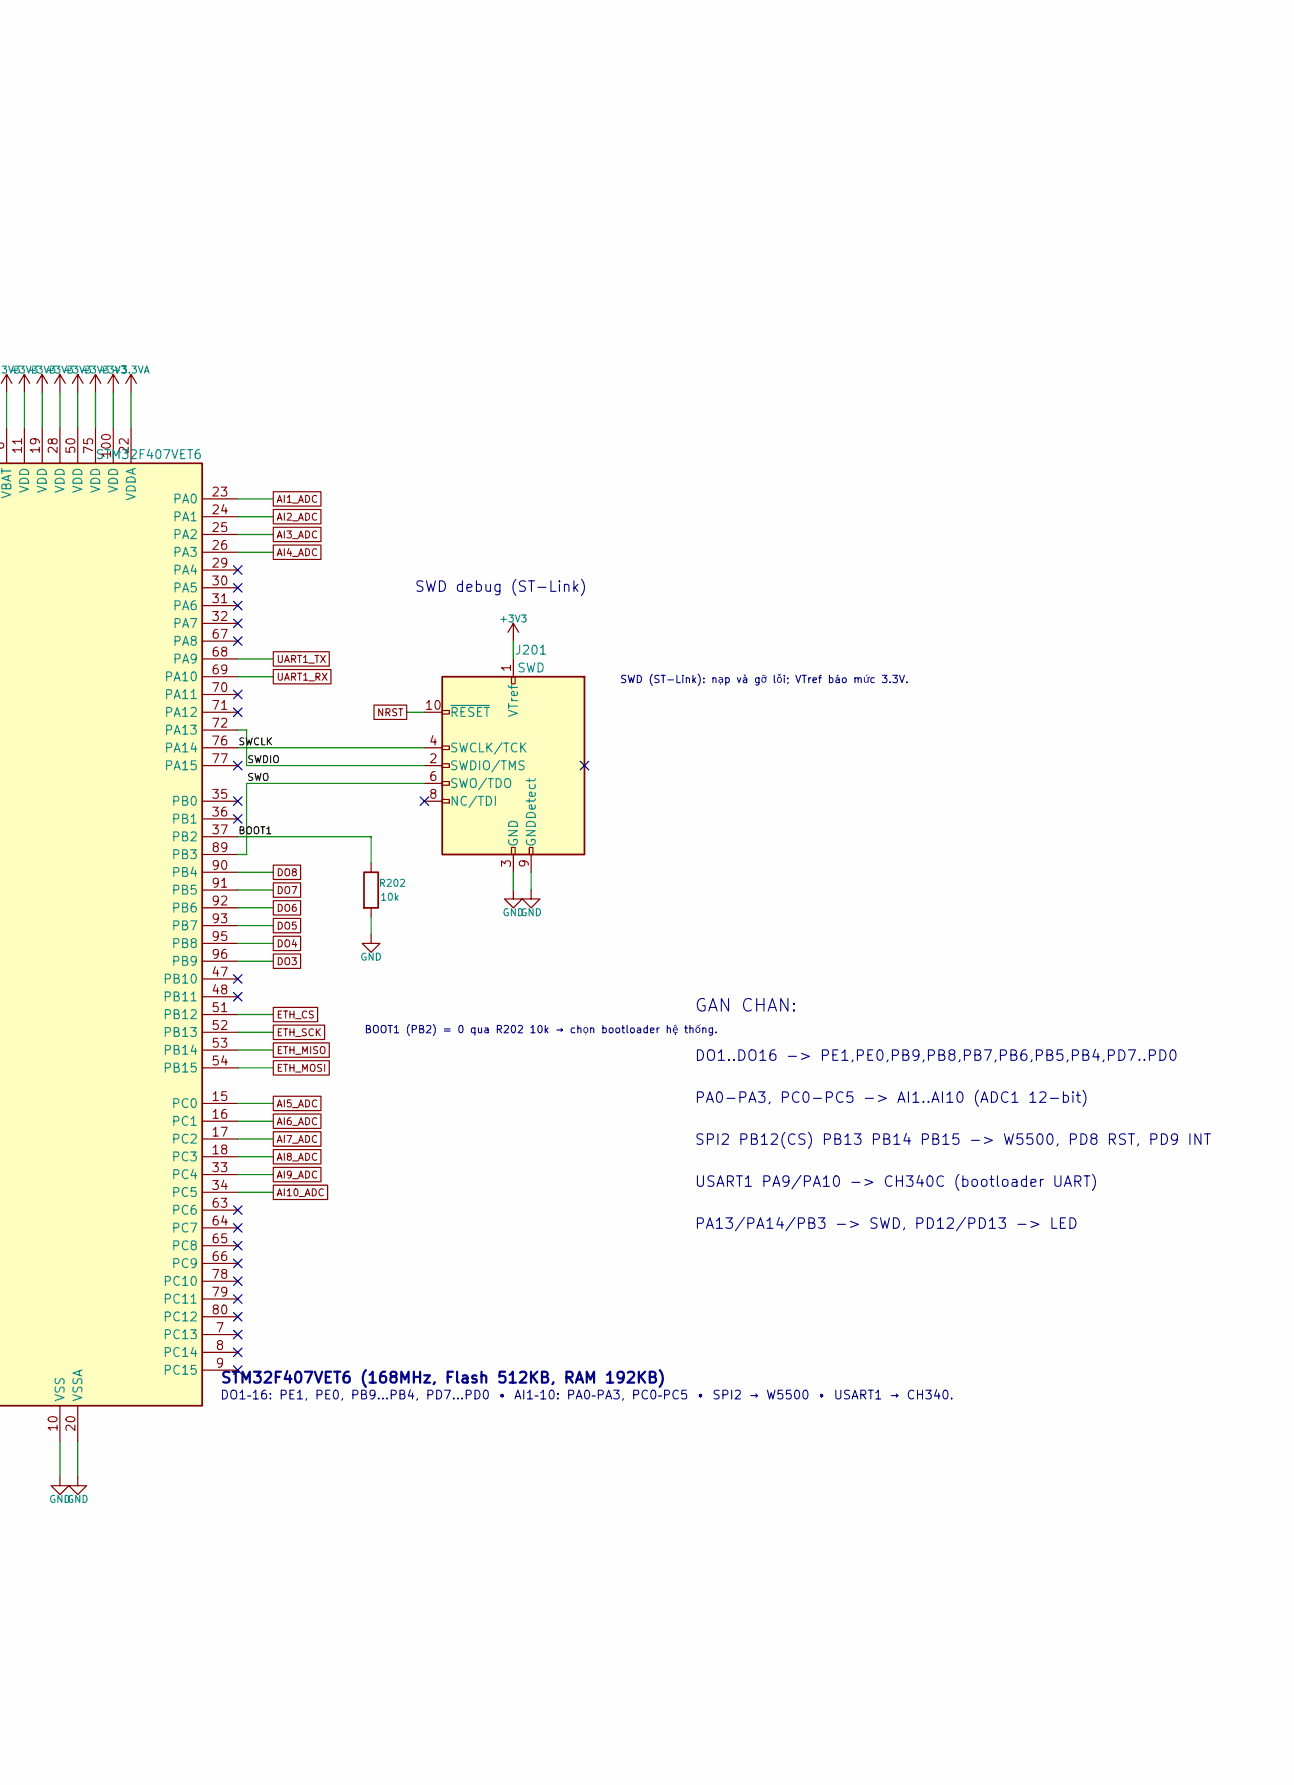
[picture p12: schematic mcu.kicad_sch, Vi dieu khien STM32F407VET6, part in row 1, column 2]

Parts:
C201, C202: 20pF; C_0603_1608Metric
C203, C204, C205, C206, C207, C208, C211, C215, C216: 100nF; C_0603_1608Metric
C209: 4.7uF; C_0805_2012Metric
C210, C214: 1uF; C_0603_1608Metric
C212, C213: 2.2uF; C_0805_2012Metric
D201: RUN (green); LED_0603_1608Metric
D202: ERR (red); LED_0603_1608Metric
J201: SWD; PinHeader_2x05_P1.27mm_Vertical_SMD
R201, R202: 10k; R_0603_1608Metric
R203, R204: 1k; R_0603_1608Metric
SW201: RESET; SW_SPST_PTS810
SW202: BOOT; SW_SPST_PTS810
U200: STM32F407VET6; LQFP-100_14x14mm_P0.5mm
U201: REF3030; SOT-23
Y201: 8MHz 20pF; Crystal_SMD_3225-4Pin_3.2x2.5mm

Connections:
+3.3VA: C210.1, C211.1, U200.22 (VDDA), U201.1 (IN); also elsewhere on the board
+3V3: C203.1, C204.1, C205.1, C206.1, C207.1, C208.1, C209.1, J201.1 (VTref), SW202.1, U200.6 (VBAT), U200.11 (VDD), U200.19 (VDD), U200.28 (VDD), U200.50 (VDD), U200.75 (VDD), U200.100 (VDD); also elsewhere on the board
/MCU STM32F407VET6/BOOT1: R202.1, U200.37 (PB2)
/MCU STM32F407VET6/ERR_A: D202.2 (A), R204.2
/MCU STM32F407VET6/LED_ERR: R204.1, U200.60 (PD13)
/MCU STM32F407VET6/LED_RUN: R203.1, U200.59 (PD12)
/MCU STM32F407VET6/OSC_IN: C201.1, U200.12 (PH0), Y201.1
/MCU STM32F407VET6/OSC_OUT: C202.1, U200.13 (PH1), Y201.3
/MCU STM32F407VET6/RUN_A: D201.2 (A), R203.2
/MCU STM32F407VET6/SWCLK: J201.4 (SWCLK/TCK), U200.76 (PA14)
/MCU STM32F407VET6/SWDIO: J201.2 (SWDIO/TMS), U200.72 (PA13)
/MCU STM32F407VET6/SWO: J201.6 (SWO/TDO), U200.89 (PB3)
/MCU STM32F407VET6/VCAP1: C212.1, U200.49 (VCAP_1)
/MCU STM32F407VET6/VCAP2: C213.1, U200.73 (VCAP_2)
/MCU STM32F407VET6/VREF_3V0: C214.1, C215.1, U200.21 (VREF+), U201.2 (OUT)
AI1_ADC: U200.23 (PA0); also elsewhere on the board
AI2_ADC: U200.24 (PA1); also elsewhere on the board
AI3_ADC: U200.25 (PA2); also elsewhere on the board
AI4_ADC: U200.26 (PA3); also elsewhere on the board
AI5_ADC: U200.15 (PC0); also elsewhere on the board
AI6_ADC: U200.16 (PC1); also elsewhere on the board
AI7_ADC: U200.17 (PC2); also elsewhere on the board
AI8_ADC: U200.18 (PC3); also elsewhere on the board
AI9_ADC: U200.33 (PC4); also elsewhere on the board
AI10_ADC: U200.34 (PC5); also elsewhere on the board
BOOT0: R201.1, SW202.2, U200.94 (BOOT0); also elsewhere on the board
DO1: U200.98 (PE1); also elsewhere on the board
DO2: U200.97 (PE0); also elsewhere on the board
DO3: U200.96 (PB9); also elsewhere on the board
DO4: U200.95 (PB8); also elsewhere on the board
DO5: U200.93 (PB7); also elsewhere on the board
DO6: U200.92 (PB6); also elsewhere on the board
DO7: U200.91 (PB5); also elsewhere on the board
DO8: U200.90 (PB4); also elsewhere on the board
DO9: U200.88 (PD7); also elsewhere on the board
DO10: U200.87 (PD6); also elsewhere on the board
DO11: U200.86 (PD5); also elsewhere on the board
DO12: U200.85 (PD4); also elsewhere on the board
DO13: U200.84 (PD3); also elsewhere on the board
DO14: U200.83 (PD2); also elsewhere on the board
DO15: U200.82 (PD1); also elsewhere on the board
DO16: U200.81 (PD0); also elsewhere on the board
ETH_CS: U200.51 (PB12); also elsewhere on the board
ETH_INT: U200.56 (PD9); also elsewhere on the board
ETH_MISO: U200.53 (PB14); also elsewhere on the board
ETH_MOSI: U200.54 (PB15); also elsewhere on the board
ETH_RST: U200.55 (PD8); also elsewhere on the board
ETH_SCK: U200.52 (PB13); also elsewhere on the board
GND: C201.2, C202.2, C203.2, C204.2, C205.2, C206.2, C207.2, C208.2, C209.2, C210.2, C211.2, C212.2, C213.2, C214.2, C215.2, C216.2, D201.1 (K), D202.1 (K), J201.3 (GND), J201.5 (GND), J201.9 (GNDDetect), R201.2, R202.2, SW201.2, U200.10 (VSS), U200.20 (VSSA), U200.27 (VSS), U200.74 (VSS), U200.99 (VSS), U201.3 (GND), Y201.2 (G), Y201.4 (G); also elsewhere on the board
NRST: C216.1, J201.10 (~RESET), SW201.1, U200.14 (NRST); also elsewhere on the board
UART1_RX: U200.69 (PA10); also elsewhere on the board
UART1_TX: U200.68 (PA9); also elsewhere on the board

Notes on the sheet:
VDDA: C210 1µF + C211 100nF – nguồn sạch cho ADC.
DO1..DO16 -> PE1,PE0,PB9,PB8,PB7,PB6,PB5,PB4,PD7..PD0
BOOT1 (PB2) = 0 qua R202 10k → chọn bootloader hệ thống.
STM32F407VET6 (168MHz, Flash 512KB, RAM 192KB)
LED RUN/ERR: I = (3.3V − 2.0V)/1kΩ ≈ 1.3mA (GPIO ≤ 25mA).
REF3030: VREF+ = 3.000V ±0.2% → 1 LSB = 3.0V/4096 ≈ 0.73mV. C214 1µF + C215 100nF giữ ổn định.
BOOT0: R201 10k kéo xuống → chạy từ Flash. Giữ BOOT khi reset → BOOT0 = 1 → bootloader UART.
RESET / BOOT
NRST: C216 100nF lọc nhiễu + nút RESET (trở kéo lên 40k có sẵn trong chip).
PA13/PA14/PB3 -> SWD, PD12/PD13 -> LED
DO1–16: PE1, PE0, PB9…PB4, PD7…PD0 • AI1–10: PA0–PA3, PC0–PC5 • SPI2 → W5500 • USART1 → CH340.
USART1 PA9/PA10 -> CH340C (bootloader UART)
Y201 8MHz → PLL 168MHz. Tụ tải C = 2·(C_L − C_stray) = 2 × (12 − 2) = 20pF (C_L theo datasheet thạch anh).
VREF+ = 3.000V
Tu loc nguon: 1 tu 100nF sat moi chan VDD; 1uF+100nF cho VDDA
C203–C208 100nF: một tụ cho mỗi chân VDD, đặt sát chân trên PCB. C209 4.7µF: dự trữ chung (ST AN4488).
HSE 8MHz
GAN CHAN:
SWD debug (ST-Link)
VCAP 2.2µF ESR thấp: bắt buộc cho ổn áp 1.2V của lõi (datasheet).
PA0-PA3, PC0-PC5 -> AI1..AI10 (ADC1 12-bit)
SWD (ST-Link): nạp và gỡ lỗi; VTref báo mức 3.3V.
LED trang thai
SPI2 PB12(CS) PB13 PB14 PB15 -> W5500, PD8 RST, PD9 INT

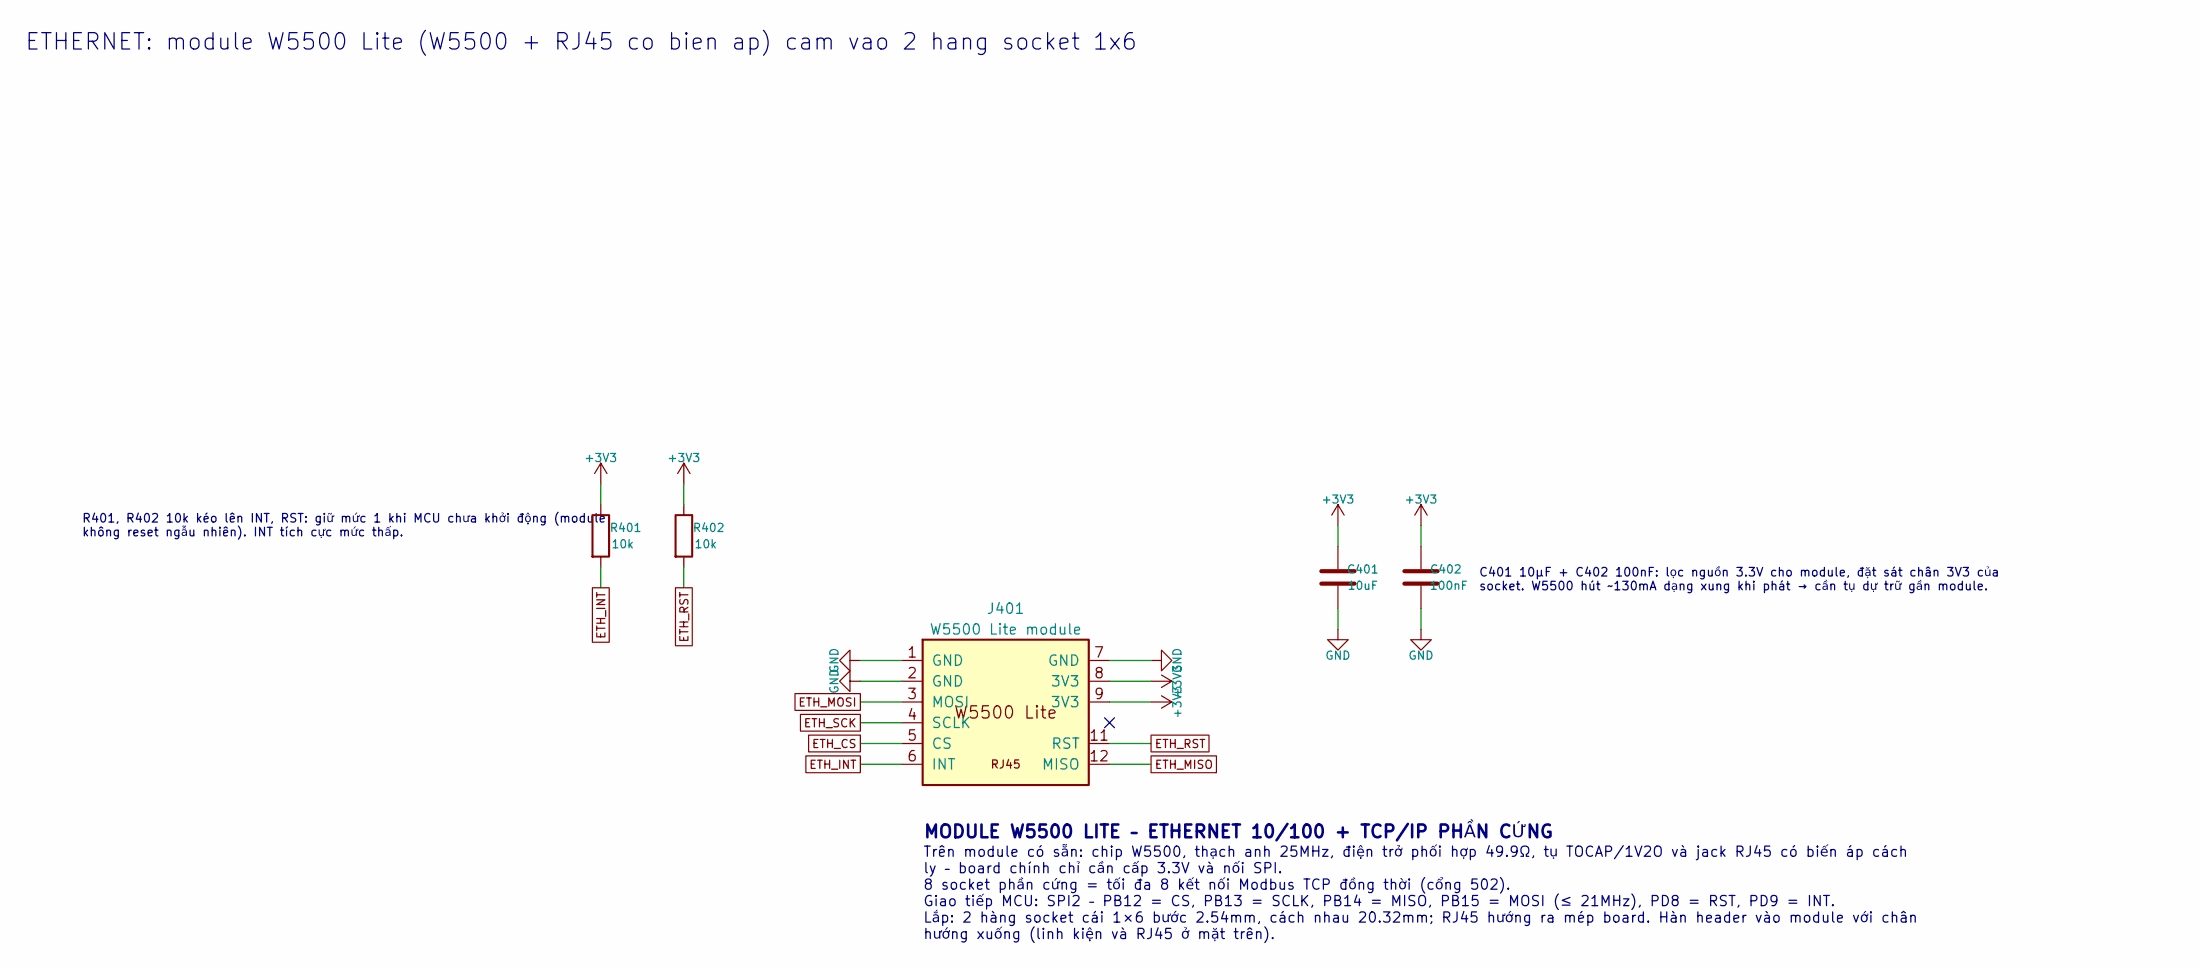
[picture p13: schematic comm.kicad_sch, Ethernet - module W5500 Lite (Modbus TCP)]

Parts:
C401: 10uF; C_0805_2012Metric
C402: 100nF; C_0603_1608Metric
J401: W5500 Lite module; W5500_Lite_Module
R401, R402: 10k; R_0603_1608Metric

Connections:
+3V3: C401.1, C402.1, J401.8 (3V3), J401.9 (3V3), R401.1, R402.1; also elsewhere on the board
ETH_CS: J401.5 (CS); also elsewhere on the board
ETH_INT: J401.6 (INT), R401.2; also elsewhere on the board
ETH_MISO: J401.12 (MISO); also elsewhere on the board
ETH_MOSI: J401.3 (MOSI); also elsewhere on the board
ETH_RST: J401.11 (RST), R402.2; also elsewhere on the board
ETH_SCK: J401.4 (SCLK); also elsewhere on the board
GND: C401.2, C402.2, J401.1 (GND), J401.2 (GND), J401.7 (GND); also elsewhere on the board

Notes on the sheet:
MODULE W5500 LITE – ETHERNET 10/100 + TCP/IP PHẦN CỨNG
C401 10µF + C402 100nF: lọc nguồn 3.3V cho module, đặt sát chân 3V3 của socket. W5500 hút ~130mA dạng xung khi phát → cần tụ dự trữ gần module.
R401, R402 10k kéo lên INT, RST: giữ mức 1 khi MCU chưa khởi động (module không reset ngẫu nhiên). INT tích cực mức thấp.
ETHERNET: module W5500 Lite (W5500 + RJ45 co bien ap) cam vao 2 hang socket 1x6
Trên module có sẵn: chip W5500, thạch anh 25MHz, điện trở phối hợp 49.9Ω, tụ TOCAP/1V2O và jack RJ45 có biến áp cách ly – board chính chỉ cần cấp 3.3V và nối SPI. 8 socket phần cứng = tối đa 8 kết nối Modbus TCP đồng thời (cổng 502). Giao tiếp MCU: SPI2 – PB12 = CS, PB13 = SCLK, PB14 = MISO, PB15 =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

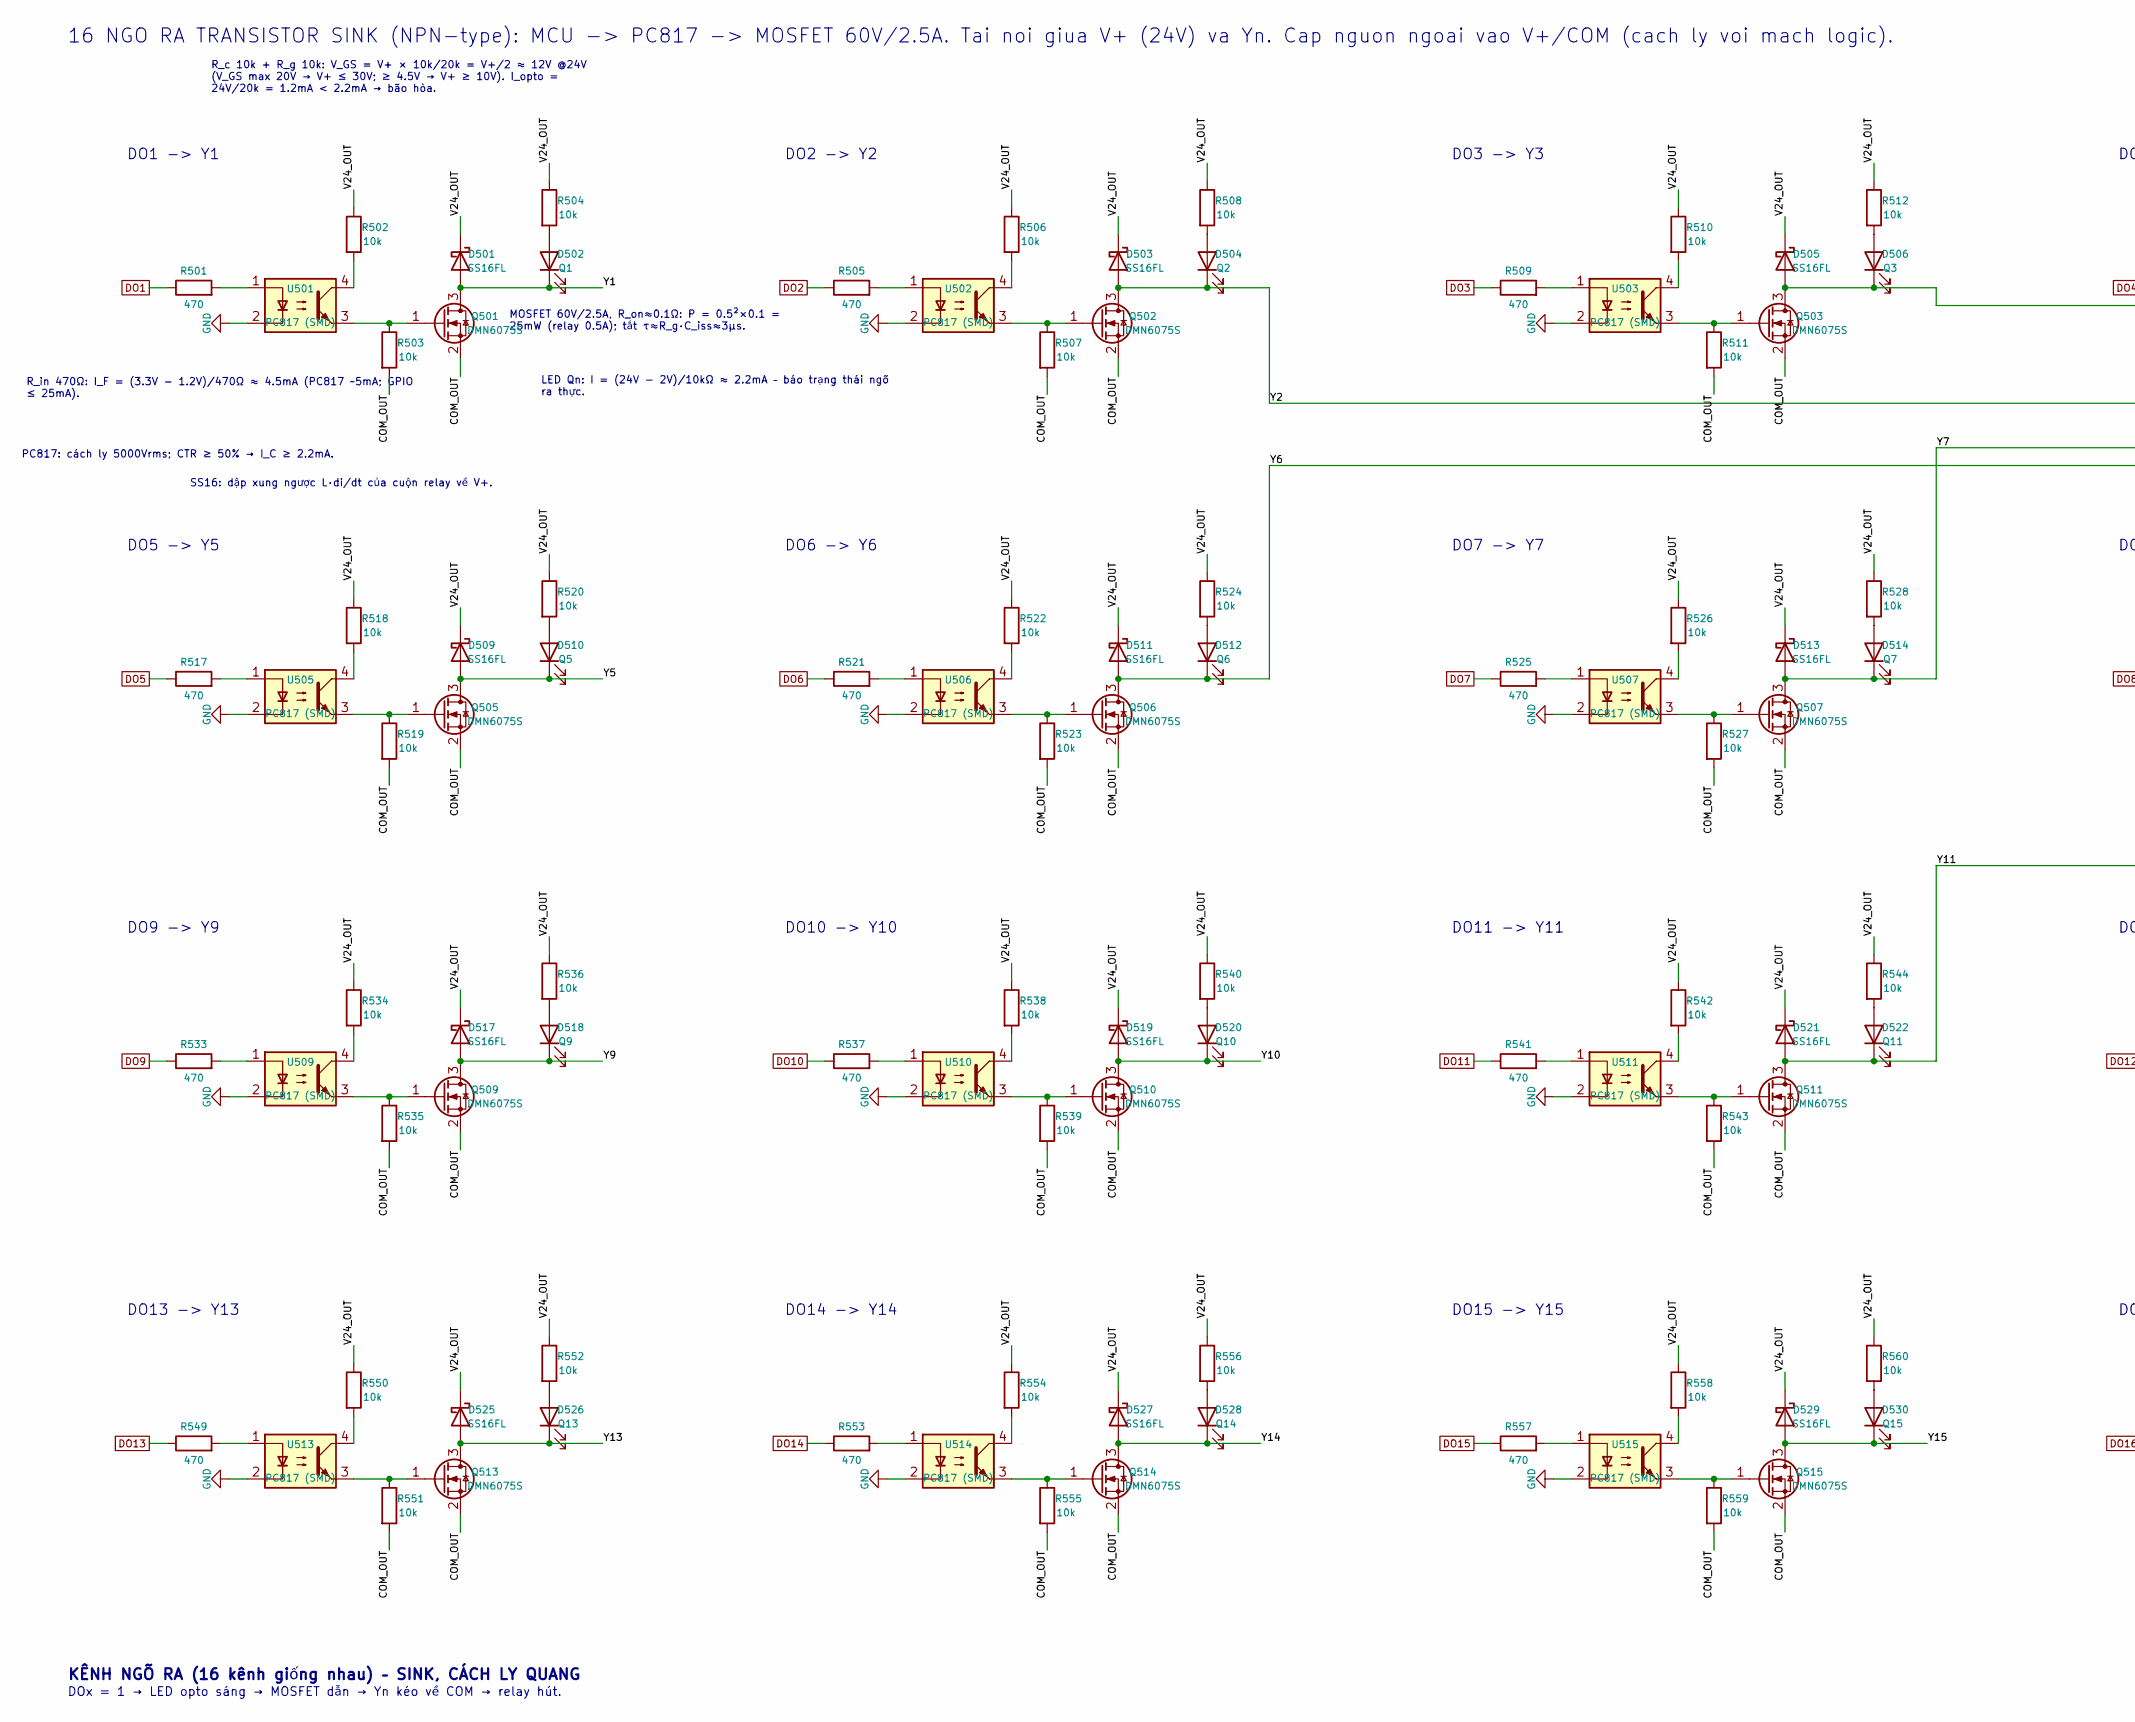
[picture p14: schematic outputs.kicad_sch, 16 ngo ra transistor (sink), cach ly quang, part in row 1, column 1]

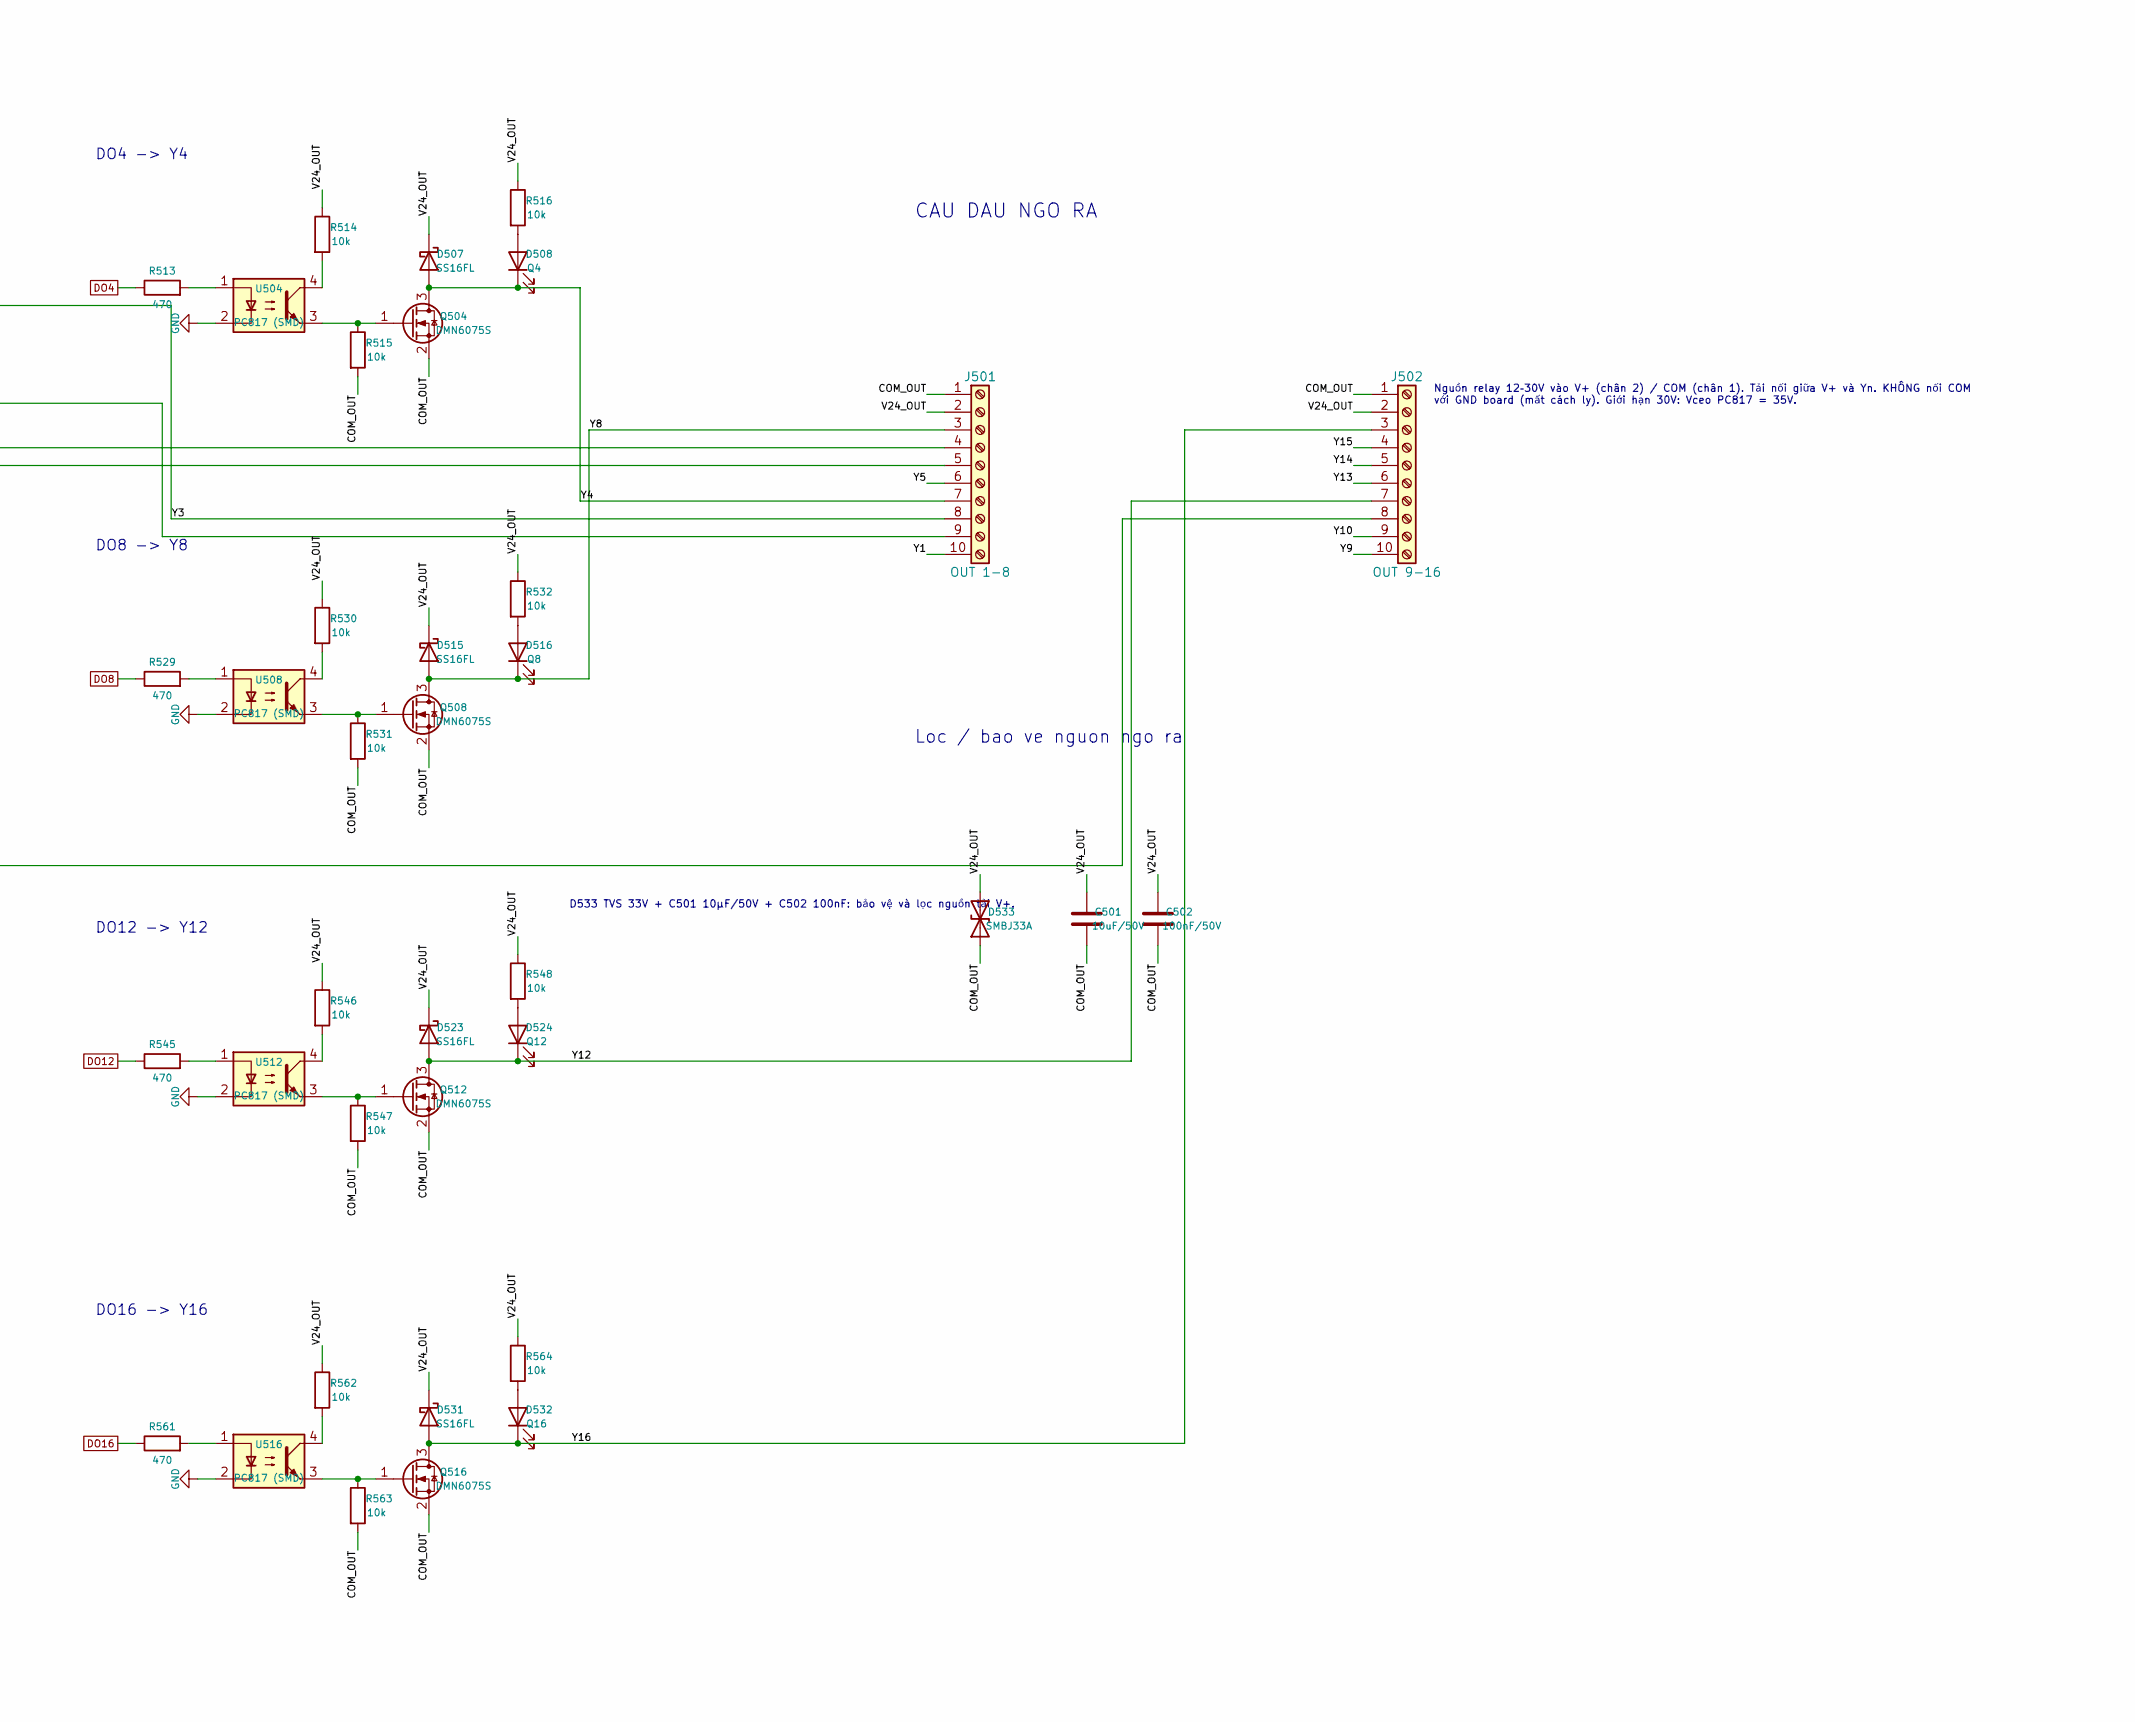
[picture p15: schematic outputs.kicad_sch, 16 ngo ra transistor (sink), cach ly quang, part in row 1, column 2]

Parts:
C501: 10uF/50V; C_1206_3216Metric
C502: 100nF/50V; C_0805_2012Metric
D501, D503, D505, D507, D509, D511, D513, D515, D517, D519, D521, D523, D525, D527, D529, D531: SS16FL; D_SOD-123F
D502: Q1; LED_0603_1608Metric
D504: Q2; LED_0603_1608Metric
D506: Q3; LED_0603_1608Metric
D508: Q4; LED_0603_1608Metric
D510: Q5; LED_0603_1608Metric
D512: Q6; LED_0603_1608Metric
D514: Q7; LED_0603_1608Metric
D516: Q8; LED_0603_1608Metric
D518: Q9; LED_0603_1608Metric
D520: Q10; LED_0603_1608Metric
D522: Q11; LED_0603_1608Metric
D524: Q12; LED_0603_1608Metric
D526: Q13; LED_0603_1608Metric
D528: Q14; LED_0603_1608Metric
D530: Q15; LED_0603_1608Metric
D532: Q16; LED_0603_1608Metric
D533: SMBJ33A; D_SMB
J501: OUT 1-8; TerminalBlock_Phoenix_MKDS-1-10-3.81_1x10_P3.81mm_Horizontal
J502: OUT 9-16; TerminalBlock_Phoenix_MKDS-1-10-3.81_1x10_P3.81mm_Horizontal
Q501, Q502, Q503, Q504, Q505, Q506, Q507, Q508, Q509, Q510, Q511, Q512, Q513, Q514, Q515, Q516: DMN6075S; SOT-23
R501, R505, R509, R513, R517, R521, R525, R529, R533, R537, R541, R545, R549, R553, R557, R561: 470; R_0603_1608Metric
R502, R503, R504, R506, R507, R508, R510, R511, R512, R514, R515, R516, R518, R519, R520, R522, R523, R524, R526, R527, R528, R530, R531, R532, R534, R535, R536, R538, R539, R540, R542, R543, R544, R546, R547, R548, R550, R551, R552, R554, R555, R556, R558, R559, R560, R562, R563, R564: 10k; R_0603_1608Metric
U501, U502, U503, U504, U505, U506, U507, U508, U509, U510, U511, U512, U513, U514, U515, U516: PC817 (SMD); SMDIP-4_W9.53mm

Connections:
/16 ngo ra transistor/COM_OUT: C501.2, C502.2, D533.1 (A1), J501.1, J502.1, Q501.2 (S), Q502.2 (S), Q503.2 (S), Q504.2 (S), Q505.2 (S), Q506.2 (S), Q507.2 (S), Q508.2 (S), Q509.2 (S), Q510.2 (S), Q511.2 (S), Q512.2 (S), Q513.2 (S), Q514.2 (S), Q515.2 (S), Q516.2 (S), R503.2, R507.2, R511.2, R515.2, R519.2, R523.2, R527.2, R531.2, R535.2, R539.2, R543.2, R547.2, R551.2, R555.2, R559.2, R563.2
/16 ngo ra transistor/V24_OUT: C501.1, C502.1, D501.1 (K), D503.1 (K), D505.1 (K), D507.1 (K), D509.1 (K), D511.1 (K), D513.1 (K), D515.1 (K), D517.1 (K), D519.1 (K), D521.1 (K), D523.1 (K), D525.1 (K), D527.1 (K), D529.1 (K), D531.1 (K), D533.2 (A2), J501.2, J502.2, R502.1, R504.1, R506.1, R508.1, R510.1, R512.1, R514.1, R516.1, R518.1, R520.1, R522.1, R524.1, R526.1, R528.1, R530.1, R532.1, R534.1, R536.1, R538.1, R540.1, R542.1, R544.1, R546.1, R548.1, R550.1, R552.1, R554.1, R556.1, R558.1, R560.1, R562.1, R564.1
/16 ngo ra transistor/Y1: D501.2 (A), D502.1 (K), J501.10, Q501.3 (D)
/16 ngo ra transistor/Y2: D503.2 (A), D504.1 (K), J501.9, Q502.3 (D)
/16 ngo ra transistor/Y3: D505.2 (A), D506.1 (K), J501.8, Q503.3 (D)
/16 ngo ra transistor/Y4: D507.2 (A), D508.1 (K), J501.7, Q504.3 (D)
/16 ngo ra transistor/Y5: D509.2 (A), D510.1 (K), J501.6, Q505.3 (D)
/16 ngo ra transistor/Y6: D511.2 (A), D512.1 (K), J501.5, Q506.3 (D)
/16 ngo ra transistor/Y7: D513.2 (A), D514.1 (K), J501.4, Q507.3 (D)
/16 ngo ra transistor/Y8: D515.2 (A), D516.1 (K), J501.3, Q508.3 (D)
/16 ngo ra transistor/Y9: D517.2 (A), D518.1 (K), J502.10, Q509.3 (D)
/16 ngo ra transistor/Y10: D519.2 (A), D520.1 (K), J502.9, Q510.3 (D)
/16 ngo ra transistor/Y11: D521.2 (A), D522.1 (K), J502.8, Q511.3 (D)
/16 ngo ra transistor/Y12: D523.2 (A), D524.1 (K), J502.7, Q512.3 (D)
/16 ngo ra transistor/Y13: D525.2 (A), D526.1 (K), J502.6, Q513.3 (D)
/16 ngo ra transistor/Y14: D527.2 (A), D528.1 (K), J502.5, Q514.3 (D)
/16 ngo ra transistor/Y15: D529.2 (A), D530.1 (K), J502.4, Q515.3 (D)
/16 ngo ra transistor/Y16: D531.2 (A), D532.1 (K), J502.3, Q516.3 (D)
DO1: R501.1; also elsewhere on the board
DO2: R505.1; also elsewhere on the board
DO3: R509.1; also elsewhere on the board
DO4: R513.1; also elsewhere on the board
DO5: R517.1; also elsewhere on the board
DO6: R521.1; also elsewhere on the board
DO7: R525.1; also elsewhere on the board
DO8: R529.1; also elsewhere on the board
DO9: R533.1; also elsewhere on the board
DO10: R537.1; also elsewhere on the board
DO11: R541.1; also elsewhere on the board
DO12: R545.1; also elsewhere on the board
DO13: R549.1; also elsewhere on the board
DO14: R553.1; also elsewhere on the board
DO15: R557.1; also elsewhere on the board
DO16: R561.1; also elsewhere on the board
GND: U501.2, U502.2, U503.2, U504.2, U505.2, U506.2, U507.2, U508.2, U509.2, U510.2, U511.2, U512.2, U513.2, U514.2, U515.2, U516.2; also elsewhere on the board
unnamed: D502.2 (A), R504.2
unnamed: D504.2 (A), R508.2
unnamed: D506.2 (A), R512.2
unnamed: D508.2 (A), R516.2
unnamed: D510.2 (A), R520.2
unnamed: D512.2 (A), R524.2
unnamed: D514.2 (A), R528.2
unnamed: D516.2 (A), R532.2
unnamed: D518.2 (A), R536.2
unnamed: D520.2 (A), R540.2
unnamed: D522.2 (A), R544.2
unnamed: D524.2 (A), R548.2
unnamed: D526.2 (A), R552.2
unnamed: D528.2 (A), R556.2
unnamed: D530.2 (A), R560.2
unnamed: D532.2 (A), R564.2
unnamed: Q501.1 (G), R503.1, U501.3
unnamed: Q502.1 (G), R507.1, U502.3
unnamed: Q503.1 (G), R511.1, U503.3
unnamed: Q504.1 (G), R515.1, U504.3
unnamed: Q505.1 (G), R519.1, U505.3
unnamed: Q506.1 (G), R523.1, U506.3
unnamed: Q507.1 (G), R527.1, U507.3
unnamed: Q508.1 (G), R531.1, U508.3
unnamed: Q509.1 (G), R535.1, U509.3
unnamed: Q510.1 (G), R539.1, U510.3
unnamed: Q511.1 (G), R543.1, U511.3
unnamed: Q512.1 (G), R547.1, U512.3
unnamed: Q513.1 (G), R551.1, U513.3
unnamed: Q514.1 (G), R555.1, U514.3
unnamed: Q515.1 (G), R559.1, U515.3
unnamed: Q516.1 (G), R563.1, U516.3
unnamed: R501.2, U501.1
unnamed: R502.2, U501.4
unnamed: R505.2, U502.1
unnamed: R506.2, U502.4
unnamed: R509.2, U503.1
unnamed: R510.2, U503.4
unnamed: R513.2, U504.1
unnamed: R514.2, U504.4
unnamed: R517.2, U505.1
unnamed: R518.2, U505.4
unnamed: R521.2, U506.1
unnamed: R522.2, U506.4
unnamed: R525.2, U507.1
unnamed: R526.2, U507.4
unnamed: R529.2, U508.1
unnamed: R530.2, U508.4
unnamed: R533.2, U509.1
unnamed: R534.2, U509.4
unnamed: R537.2, U510.1
unnamed: R538.2, U510.4
unnamed: R541.2, U511.1
unnamed: R542.2, U511.4
unnamed: R545.2, U512.1
unnamed: R546.2, U512.4
unnamed: R549.2, U513.1
unnamed: R550.2, U513.4
unnamed: R553.2, U514.1
unnamed: R554.2, U514.4
unnamed: R557.2, U515.1
unnamed: R558.2, U515.4
unnamed: R561.2, U516.1
unnamed: R562.2, U516.4

Notes on the sheet:
DO14 -> Y14
DO4 -> Y4
PC817: cách ly 5000Vrms; CTR ≥ 50% → I_C ≥ 2.2mA.
D533 TVS 33V + C501 10µF/50V + C502 100nF: bảo vệ và lọc nguồn tải V+.
KÊNH NGÕ RA (16 kênh giống nhau) – SINK, CÁCH LY QUANG
DO9 -> Y9
DO3 -> Y3
DO1 -> Y1
LED Qn: I = (24V − 2V)/10kΩ ≈ 2.2mA – báo trạng thái ngõ ra thực.
DO5 -> Y5
DO12 -> Y12
Nguồn relay 12–30V vào V+ (chân 2) / COM (chân 1). Tải nối giữa V+ và Yn. KHÔNG nối COM với GND board (mất cách ly). Giới hạn 30V: Vceo PC817 = 35V.
R_c 10k + R_g 10k: V_GS = V+ × 10k/20k = V+/2 ≈ 12V @24V (V_GS max 20V → V+ ≤ 30V; ≥ 4.5V → V+ ≥ 10V). I_opto = 24V/20k = 1.2mA < 2.2mA → bão hòa.
DO6 -> Y6
16 NGO RA TRANSISTOR SINK (NPN-type): MCU -> PC817 -> MOSFET 60V/2.5A. Tai noi giua V+ (24V) va Yn. Cap nguon ngoai vao V+/COM (cach ly voi mach logic).
MOSFET 60V/2.5A, R_on≈0.1Ω: P = 0.5²×0.1 = 25mW (relay 0.5A); tắt τ≈R_g·C_iss≈3µs.
DO13 -> Y13
CAU DAU NGO RA
DO16 -> Y16
DO10 -> Y10
R_in 470Ω: I_F = (3.3V − 1.2V)/470Ω ≈ 4.5mA (PC817 ~5mA; GPIO ≤ 25mA).
DO7 -> Y7
DO2 -> Y2
DO11 -> Y11
DO8 -> Y8
DOx = 1 → LED opto sáng → MOSFET dẫn → Yn kéo về COM → relay hút.
Loc / bao ve nguon ngo ra
DO15 -> Y15
SS16: dập xung ngược L·di/dt của cuộn relay về V+.
