danhmanu/PLC-STM32F407VET6/kicad/PLC_STM32_Modbus.kicad_pcb

## KiCad design kicad/PLC_STM32_Modbus.kicad_pcb (continued)

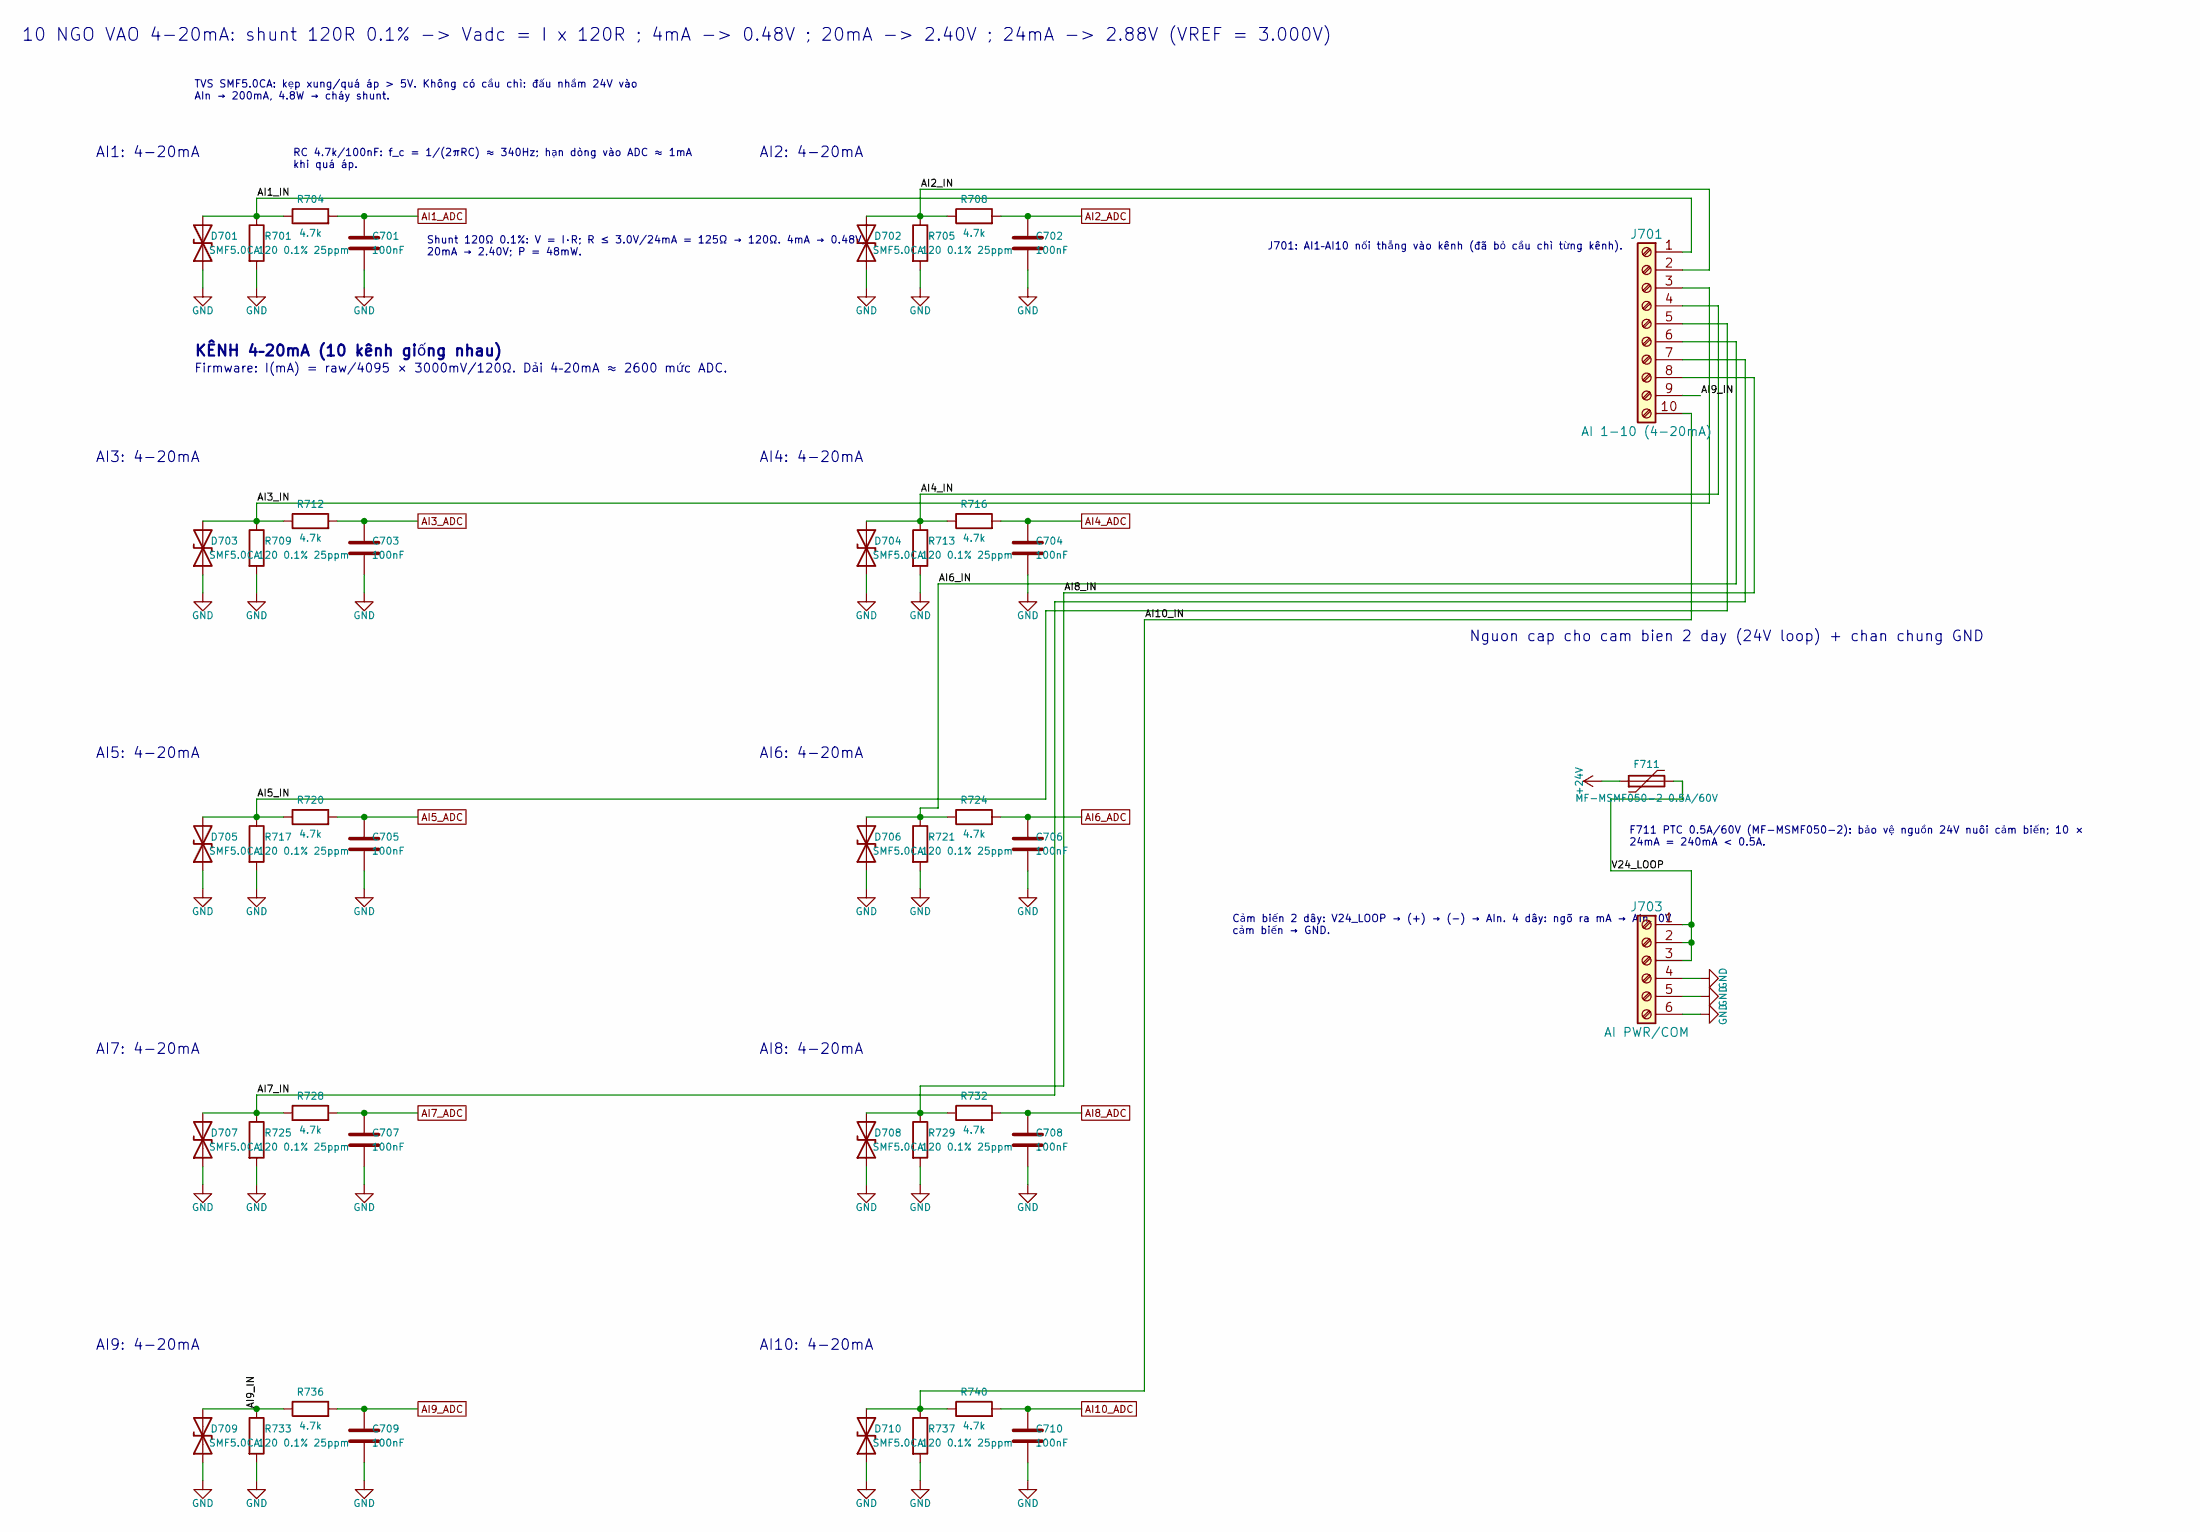
[picture p16: schematic analog.kicad_sch, 10 ngo vao analog 4-20mA]

Parts:
C701, C702, C703, C704, C705, C706, C707, C708, C709, C710: 100nF; C_0603_1608Metric
D701, D702, D703, D704, D705, D706, D707, D708, D709, D710: SMF5.0CA; D_SOD-123F
F711: MF-MSMF050-2 0.5A/60V; Fuse_1812_4532Metric
J701: AI 1-10 (4-20mA); TerminalBlock_Phoenix_MKDS-1-10-3.81_1x10_P3.81mm_Horizontal
J703: AI PWR/COM; TerminalBlock_Phoenix_MKDS-1-6-3.81_1x06_P3.81mm_Horizontal
R701, R705, R709, R713, R717, R721, R725, R729, R733, R737: 120 0.1% 25ppm; R_1206_3216Metric
R704, R708, R712, R716, R720, R724, R728, R732, R736, R740: 4.7k; R_0603_1608Metric

Connections:
+24V: F711.1; also elsewhere on the board
/10 ngo vao analog/AI1_IN: D701.2 (A2), J701.1, R701.1, R704.1
/10 ngo vao analog/AI2_IN: D702.2 (A2), J701.2, R705.1, R708.1
/10 ngo vao analog/AI3_IN: D703.2 (A2), J701.3, R709.1, R712.1
/10 ngo vao analog/AI4_IN: D704.2 (A2), J701.4, R713.1, R716.1
/10 ngo vao analog/AI5_IN: D705.2 (A2), J701.5, R717.1, R720.1
/10 ngo vao analog/AI6_IN: D706.2 (A2), J701.6, R721.1, R724.1
/10 ngo vao analog/AI7_IN: D707.2 (A2), J701.7, R725.1, R728.1
/10 ngo vao analog/AI8_IN: D708.2 (A2), J701.8, R729.1, R732.1
/10 ngo vao analog/AI9_IN: D709.2 (A2), J701.9, R733.1, R736.1
/10 ngo vao analog/AI10_IN: D710.2 (A2), J701.10, R737.1, R740.1
/10 ngo vao analog/V24_LOOP: F711.2, J703.1, J703.2, J703.3
AI1_ADC: C701.1, R704.2; also elsewhere on the board
AI2_ADC: C702.1, R708.2; also elsewhere on the board
AI3_ADC: C703.1, R712.2; also elsewhere on the board
AI4_ADC: C704.1, R716.2; also elsewhere on the board
AI5_ADC: C705.1, R720.2; also elsewhere on the board
AI6_ADC: C706.1, R724.2; also elsewhere on the board
AI7_ADC: C707.1, R728.2; also elsewhere on the board
AI8_ADC: C708.1, R732.2; also elsewhere on the board
AI9_ADC: C709.1, R736.2; also elsewhere on the board
AI10_ADC: C710.1, R740.2; also elsewhere on the board
GND: C701.2, C702.2, C703.2, C704.2, C705.2, C706.2, C707.2, C708.2, C709.2, C710.2, D701.1 (A1), D702.1 (A1), D703.1 (A1), D704.1 (A1), D705.1 (A1), D706.1 (A1), D707.1 (A1), D708.1 (A1), D709.1 (A1), D710.1 (A1), J703.4, J703.5, J703.6, R701.2, R705.2, R709.2, R713.2, R717.2, R721.2, R725.2, R729.2, R733.2, R737.2; also elsewhere on the board

Notes on the sheet:
AI2: 4-20mA
AI1: 4-20mA
Cảm biến 2 dây: V24_LOOP → (+) → (−) → AIn. 4 dây: ngõ ra mA → AIn, 0V cảm biến → GND.
10 NGO VAO 4-20mA: shunt 120R 0.1% -> Vadc = I x 120R ; 4mA -> 0.48V ; 20mA -> 2.40V ; 24mA -> 2.88V (VREF = 3.000V)
KÊNH 4–20mA (10 kênh giống nhau)
F711 PTC 0.5A/60V (MF-MSMF050-2): bảo vệ nguồn 24V nuôi cảm biến; 10 × 24mA = 240mA < 0.5A.
AI9: 4-20mA
AI5: 4-20mA
AI6: 4-20mA
TVS SMF5.0CA: kẹp xung/quá áp > 5V. Không có cầu chì: đấu nhầm 24V vào AIn → 200mA, 4.8W → cháy shunt.
AI3: 4-20mA
AI7: 4-20mA
Firmware: I(mA) = raw/4095 × 3000mV/120Ω. Dải 4–20mA ≈ 2600 mức ADC.
AI10: 4-20mA
J701: AI1–AI10 nối thẳng vào kênh (đã bỏ cầu chì từng kênh).
AI8: 4-20mA
RC 4.7k/100nF: f_c = 1/(2πRC) ≈ 340Hz; hạn dòng vào ADC ≈ 1mA khi quá áp.
Shunt 120Ω 0.1%: V = I·R; R ≤ 3.0V/24mA = 125Ω → 120Ω. 4mA → 0.48V, 20mA → 2.40V; P = 48mW.
Nguon cap cho cam bien 2 day (24V loop) + chan chung GND
AI4: 4-20mA

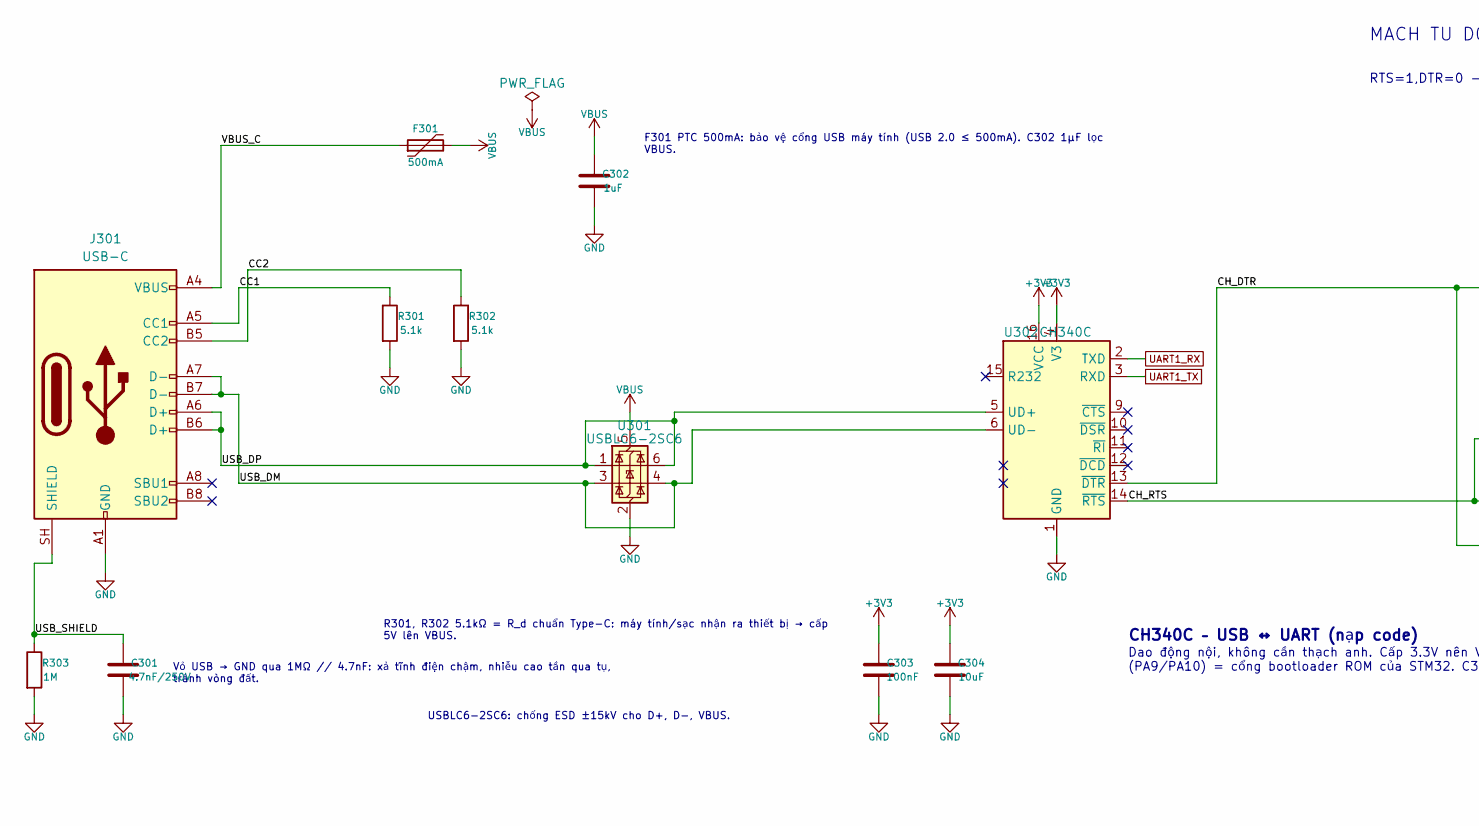
[picture p17: schematic usb.kicad_sch, USB-C -> CH340C -> USART1 + mach tu dong vao bootloader, part in row 1, column 1]

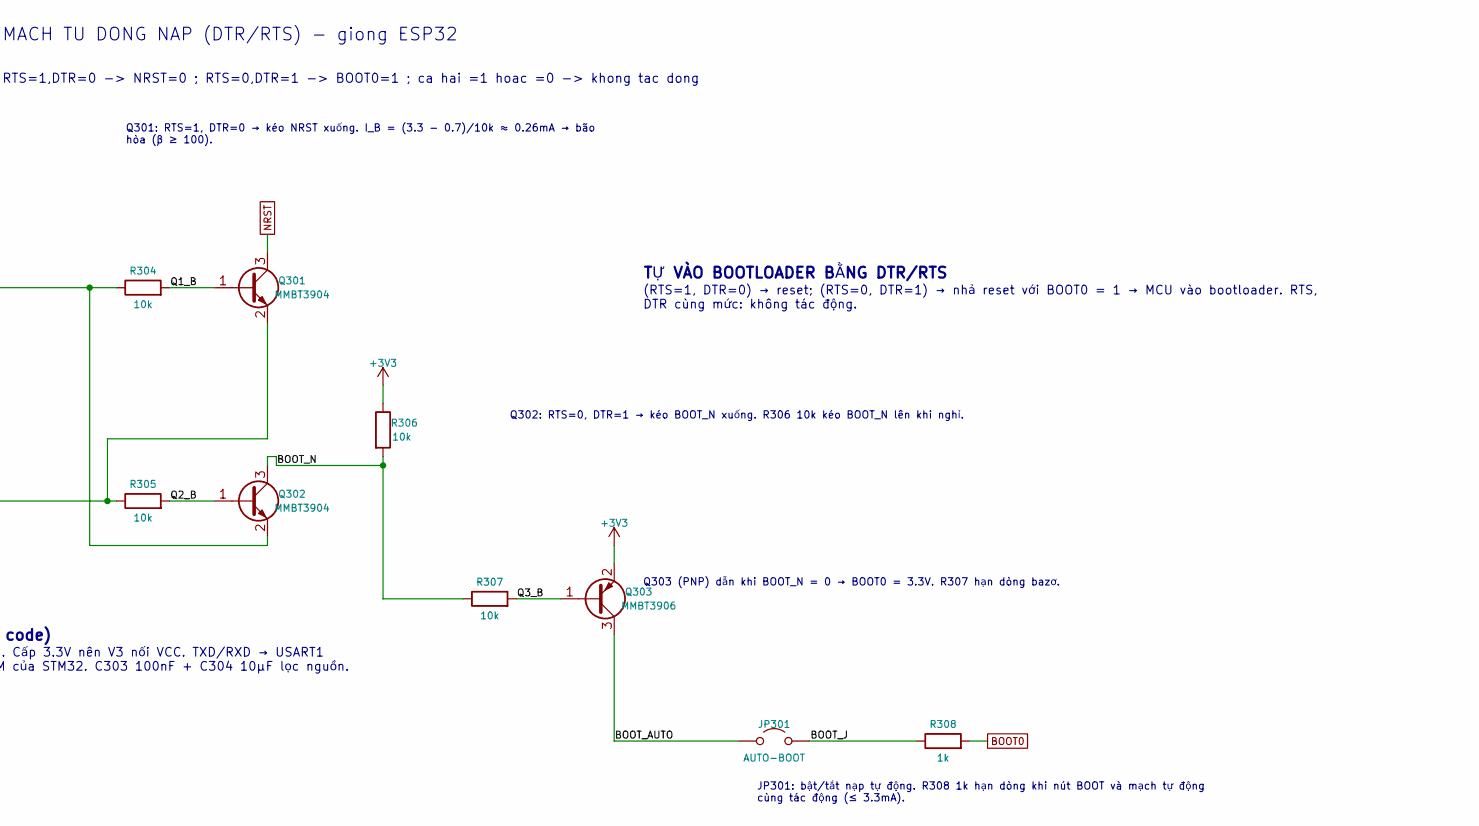
[picture p18: schematic usb.kicad_sch, USB-C -> CH340C -> USART1 + mach tu dong vao bootloader, part in row 1, column 2]

Parts:
C301: 4.7nF/250V; C_1206_3216Metric
C302: 1uF; C_0603_1608Metric
C303: 100nF; C_0603_1608Metric
C304: 10uF; C_0805_2012Metric
F301: 500mA; Fuse_1206_3216Metric
J301: USB-C; USB_C_Receptacle_GCT_USB4105-xx-A_16P_TopMnt_Horizontal
JP301: AUTO-BOOT; PinHeader_1x02_P2.54mm_Vertical
Q301, Q302: MMBT3904; SOT-23
Q303: MMBT3906; SOT-23
R301, R302: 5.1k; R_0603_1608Metric
R303: 1M; R_0603_1608Metric
R304, R305, R306, R307: 10k; R_0603_1608Metric
R308: 1k; R_0603_1608Metric
U301: USBLC6-2SC6; SOT-23-6
U302: CH340C; SOIC-16_3.9x9.9mm_P1.27mm

Connections:
+3V3: C303.1, C304.1, Q303.2 (E), R306.1, U302.4 (V3), U302.16 (VCC); also elsewhere on the board
/USB nap code/BOOT_AUTO: JP301.1 (A), Q303.3 (C)
/USB nap code/BOOT_J: JP301.2 (B), R308.1
/USB nap code/BOOT_N: Q302.3 (C), R306.2, R307.1
/USB nap code/CC1: J301.A5 (CC1), R301.1
/USB nap code/CC2: J301.B5 (CC2), R302.1
/USB nap code/CH_DTR: Q302.2 (E), R304.1, U302.13 (~DTR)
/USB nap code/CH_RTS: Q301.2 (E), R305.1, U302.14 (~RTS)
/USB nap code/Q1_B: Q301.1 (B), R304.2
/USB nap code/Q2_B: Q302.1 (B), R305.2
/USB nap code/Q3_B: Q303.1 (B), R307.2
/USB nap code/USB_DM: J301.A7 (D-), J301.B7 (D-), U301.3 (I/O2), U301.4 (I/O2), U302.6 (UD-)
/USB nap code/USB_DP: J301.A6 (D+), J301.B6 (D+), U301.1 (I/O1), U301.6 (I/O1), U302.5 (UD+)
/USB nap code/USB_SHIELD: C301.1, J301.SH (SHIELD), R303.1
/USB nap code/VBUS_C: F301.1, J301.A4 (VBUS), J301.A9 (VBUS), J301.B4 (VBUS), J301.B9 (VBUS)
BOOT0: R308.2; also elsewhere on the board
GND: C301.2, C302.2, C303.2, C304.2, J301.A1 (GND), J301.A12 (GND), J301.B1 (GND), J301.B12 (GND), R301.2, R302.2, R303.2, U301.2 (GND), U302.1 (GND); also elsewhere on the board
NRST: Q301.3 (C); also elsewhere on the board
UART1_RX: U302.2 (TXD); also elsewhere on the board
UART1_TX: U302.3 (RXD); also elsewhere on the board
VBUS: C302.1, F301.2, U301.5 (VBUS); also elsewhere on the board

Notes on the sheet:
RTS=1,DTR=0 -> NRST=0 ; RTS=0,DTR=1 -> BOOT0=1 ; ca hai =1 hoac =0 -> khong tac dong
(RTS=1, DTR=0) → reset; (RTS=0, DTR=1) → nhả reset với BOOT0 = 1 → MCU vào bootloader. RTS, DTR cùng mức: không tác động.
Q302: RTS=0, DTR=1 → kéo BOOT_N xuống. R306 10k kéo BOOT_N lên khi nghỉ.
Vỏ USB → GND qua 1MΩ // 4.7nF: xả tĩnh điện chậm, nhiễu cao tần qua tụ, tránh vòng đất.
USBLC6-2SC6: chống ESD ±15kV cho D+, D−, VBUS.
Dao động nội, không cần thạch anh. Cấp 3.3V nên V3 nối VCC. TXD/RXD → USART1 (PA9/PA10) = cổng bootloader ROM của STM32. C303 100nF + C304 10µF lọc nguồn.
MACH TU DONG NAP (DTR/RTS) - giong ESP32
F301 PTC 500mA: bảo vệ cổng USB máy tính (USB 2.0 ≤ 500mA). C302 1µF lọc VBUS.
R301, R302 5.1kΩ = R_d chuẩn Type-C: máy tính/sạc nhận ra thiết bị → cấp 5V lên VBUS.
Q301: RTS=1, DTR=0 → kéo NRST xuống. I_B = (3.3 − 0.7)/10k ≈ 0.26mA → bão hòa (β ≥ 100).
JP301: bật/tắt nạp tự động. R308 1k hạn dòng khi nút BOOT và mạch tự động cùng tác động (≤ 3.3mA).
CH340C – USB ↔ UART (nạp code)
TỰ VÀO BOOTLOADER BẰNG DTR/RTS
Q303 (PNP) dẫn khi BOOT_N = 0 → BOOT0 = 3.3V. R307 hạn dòng bazơ.

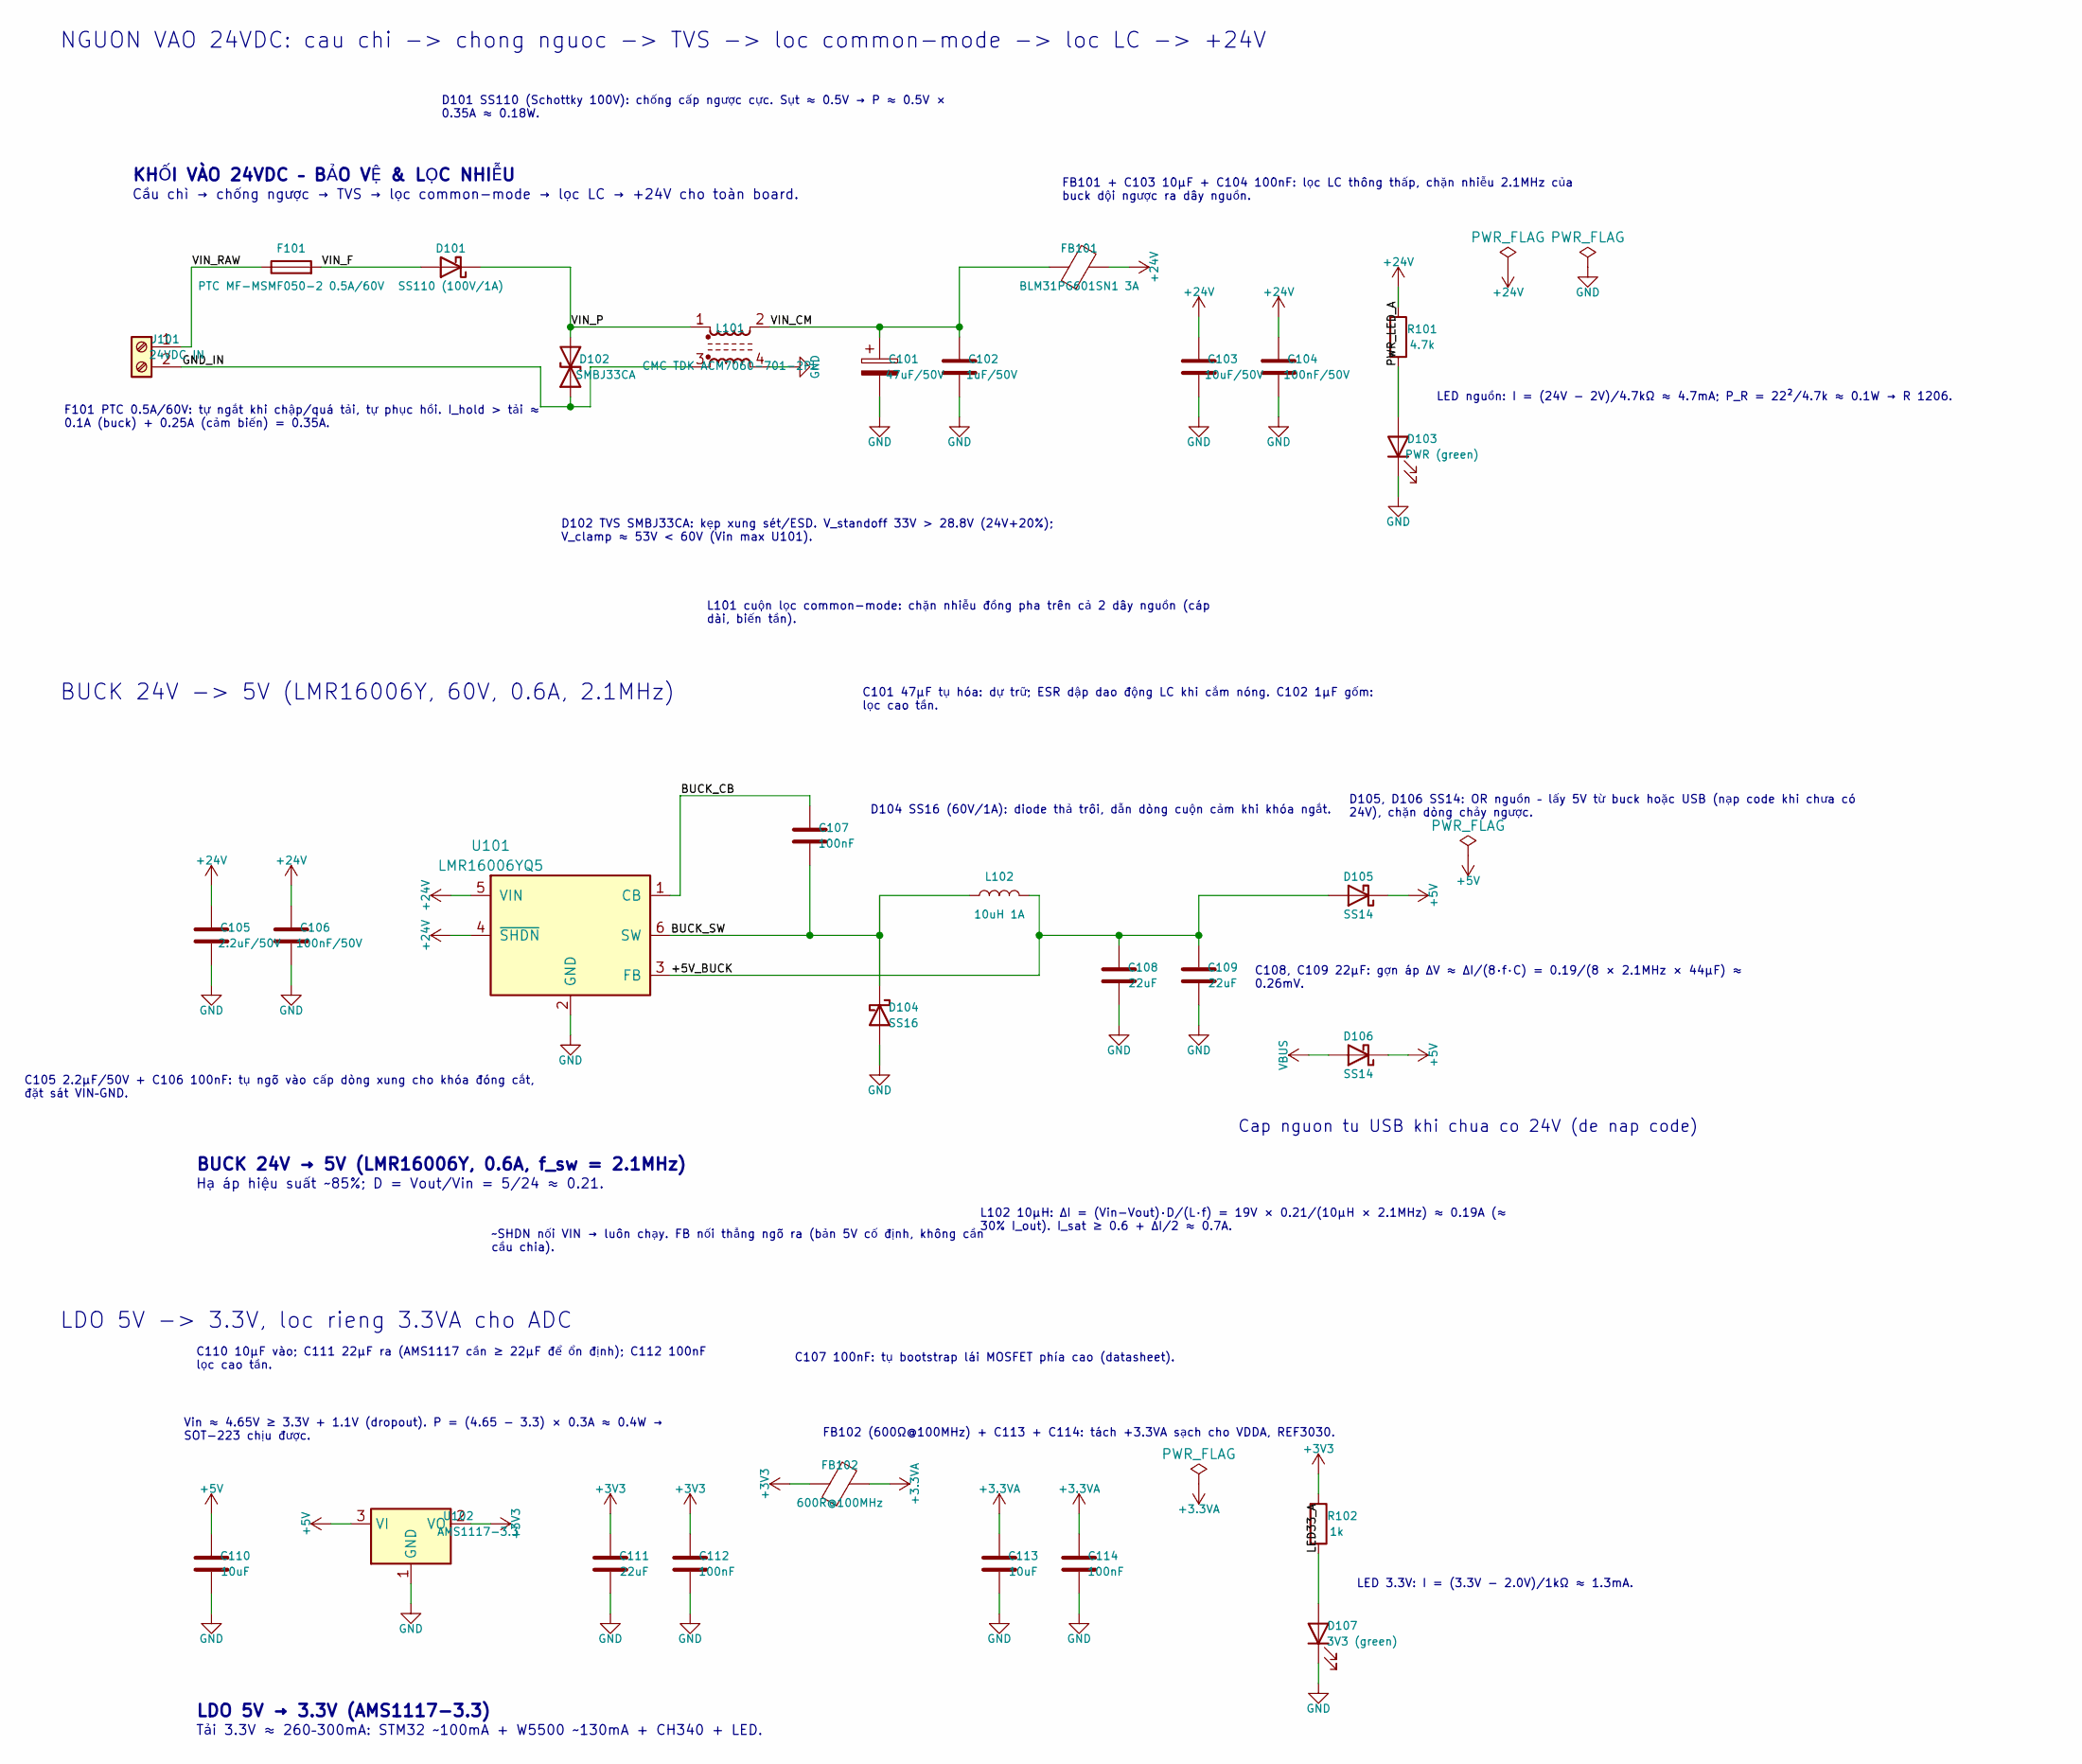
[picture p19: schematic power.kicad_sch, Nguon: loc 24VDC, buck 5V, LDO 3.3V, ref 3.0V]

Parts:
C101: 47uF/50V; CP_Elec_6.3x7.7
C102: 1uF/50V; C_1206_3216Metric
C103: 10uF/50V; C_1210_3225Metric
C104, C106: 100nF/50V; C_0805_2012Metric
C105: 2.2uF/50V; C_1206_3216Metric
C107, C112, C114: 100nF; C_0603_1608Metric
C108, C109, C111: 22uF; C_1206_3216Metric
C110, C113: 10uF; C_0805_2012Metric
D101: SS110 (100V/1A); D_SMA
D102: SMBJ33CA; D_SMB
D103: PWR (green); LED_0603_1608Metric
D104: SS16; D_SMA
D105, D106: SS14; D_SMA
D107: 3V3 (green); LED_0603_1608Metric
F101: PTC MF-MSMF050-2 0.5A/60V; Fuse_1812_4532Metric
FB101: BLM31PG601SN1 3A; L_1206_3216Metric
FB102: 600R@100MHz; L_0805_2012Metric
J101: 24VDC IN; TerminalBlock_Phoenix_MKDS-1-2-3.81_1x02_P3.81mm_Horizontal
L101: CMC TDK ACM7060-701-2PL; L_CommonModeChoke_TDK_ACM7060
L102: 10uH 1A; L_Bourns-SRN4018
R101: 4.7k; R_1206_3216Metric
R102: 1k; R_0603_1608Metric
U101: LMR16006YQ5; SOT-23-6
U102: AMS1117-3.3; SOT-223-3_TabPin2

Connections:
+3.3VA: C113.1, C114.1, FB102.2; also elsewhere on the board
+3V3: C111.1, C112.1, FB102.1, R102.1, U102.2 (VO); also elsewhere on the board
+5V: C110.1, D105.1 (K), D106.1 (K), U102.3 (VI)
+24V: C103.1, C104.1, C105.1, C106.1, FB101.2, R101.1, U101.4 (~SHDN), U101.5 (VIN); also elsewhere on the board
/Nguon 24VDC/+5V_BUCK: C108.1, C109.1, D105.2 (A), L102.2, U101.3 (FB)
/Nguon 24VDC/BUCK_CB: C107.1, U101.1 (CB)
/Nguon 24VDC/BUCK_SW: C107.2, D104.1 (K), L102.1, U101.6 (SW)
/Nguon 24VDC/GND_IN: D102.1 (A1), J101.2, L101.3
/Nguon 24VDC/LED33_A: D107.2 (A), R102.2
/Nguon 24VDC/PWR_LED_A: D103.2 (A), R101.2
/Nguon 24VDC/VIN_CM: C101.1, C102.1, FB101.1, L101.2
/Nguon 24VDC/VIN_F: D101.2 (A), F101.2
/Nguon 24VDC/VIN_P: D101.1 (K), D102.2 (A2), L101.1
/Nguon 24VDC/VIN_RAW: F101.1, J101.1
GND: C101.2, C102.2, C103.2, C104.2, C105.2, C106.2, C108.2, C109.2, C110.2, C111.2, C112.2, C113.2, C114.2, D103.1 (K), D104.2 (A), D107.1 (K), L101.4, U101.2 (GND), U102.1 (GND); also elsewhere on the board
VBUS: D106.2 (A); also elsewhere on the board

Notes on the sheet:
~SHDN nối VIN → luôn chạy. FB nối thẳng ngõ ra (bản 5V cố định, không cần cầu chia).
LDO 5V → 3.3V (AMS1117-3.3)
KHỐI VÀO 24VDC – BẢO VỆ & LỌC NHIỄU
LED nguồn: I = (24V − 2V)/4.7kΩ ≈ 4.7mA; P_R = 22²/4.7k ≈ 0.1W → R 1206.
Cap nguon tu USB khi chua co 24V (de nap code)
D105, D106 SS14: OR nguồn – lấy 5V từ buck hoặc USB (nạp code khi chưa có 24V), chặn dòng chảy ngược.
C101 47µF tụ hóa: dự trữ; ESR dập dao động LC khi cắm nóng. C102 1µF gốm: lọc cao tần.
LDO 5V -> 3.3V, loc rieng 3.3VA cho ADC
BUCK 24V → 5V (LMR16006Y, 0.6A, f_sw = 2.1MHz)
L101 cuộn lọc common-mode: chặn nhiễu đồng pha trên cả 2 dây nguồn (cáp dài, biến tần).
FB101 + C103 10µF + C104 100nF: lọc LC thông thấp, chặn nhiễu 2.1MHz của buck dội ngược ra dây nguồn.
F101 PTC 0.5A/60V: tự ngắt khi chập/quá tải, tự phục hồi. I_hold > tải ≈ 0.1A (buck) + 0.25A (cảm biến) = 0.35A.
D104 SS16 (60V/1A): diode thả trôi, dẫn dòng cuộn cảm khi khóa ngắt.
Hạ áp hiệu suất ~85%; D = Vout/Vin = 5/24 ≈ 0.21.
C105 2.2µF/50V + C106 100nF: tụ ngõ vào cấp dòng xung cho khóa đóng cắt, đặt sát VIN–GND.
D102 TVS SMBJ33CA: kẹp xung sét/ESD. V_standoff 33V > 28.8V (24V+20%); V_clamp ≈ 53V < 60V (Vin max U101).
C108, C109 22µF: gợn áp ΔV ≈ ΔI/(8·f·C) = 0.19/(8 × 2.1MHz × 44µF) ≈ 0.26mV.
Cầu chì → chống ngược → TVS → lọc common-mode → lọc LC → +24V cho toàn board.
Tải 3.3V ≈ 260–300mA: STM32 ~100mA + W5500 ~130mA + CH340 + LED.
FB102 (600Ω@100MHz) + C113 + C114: tách +3.3VA sạch cho VDDA, REF3030.
BUCK 24V -> 5V (LMR16006Y, 60V, 0.6A, 2.1MHz)
NGUON VAO 24VDC: cau chi -> chong nguoc -> TVS -> loc common-mode -> loc LC -> +24V
C107 100nF: tụ bootstrap lái MOSFET phía cao (datasheet).
L102 10µH: ΔI = (Vin−Vout)·D/(L·f) = 19V × 0.21/(10µH × 2.1MHz) ≈ 0.19A (≈ 30% I_out). I_sat ≥ 0.6 + ΔI/2 ≈ 0.7A.
D101 SS110 (Schottky 100V): chống cấp ngược cực. Sụt ≈ 0.5V → P ≈ 0.5V × 0.35A ≈ 0.18W.
C110 10µF vào; C111 22µF ra (AMS1117 cần ≥ 22µF để ổn định); C112 100nF lọc cao tần.
Vin ≈ 4.65V ≥ 3.3V + 1.1V (dropout). P = (4.65 − 3.3) × 0.3A ≈ 0.4W → SOT-223 chịu được.
LED 3.3V: I = (3.3V − 2.0V)/1kΩ ≈ 1.3mA.

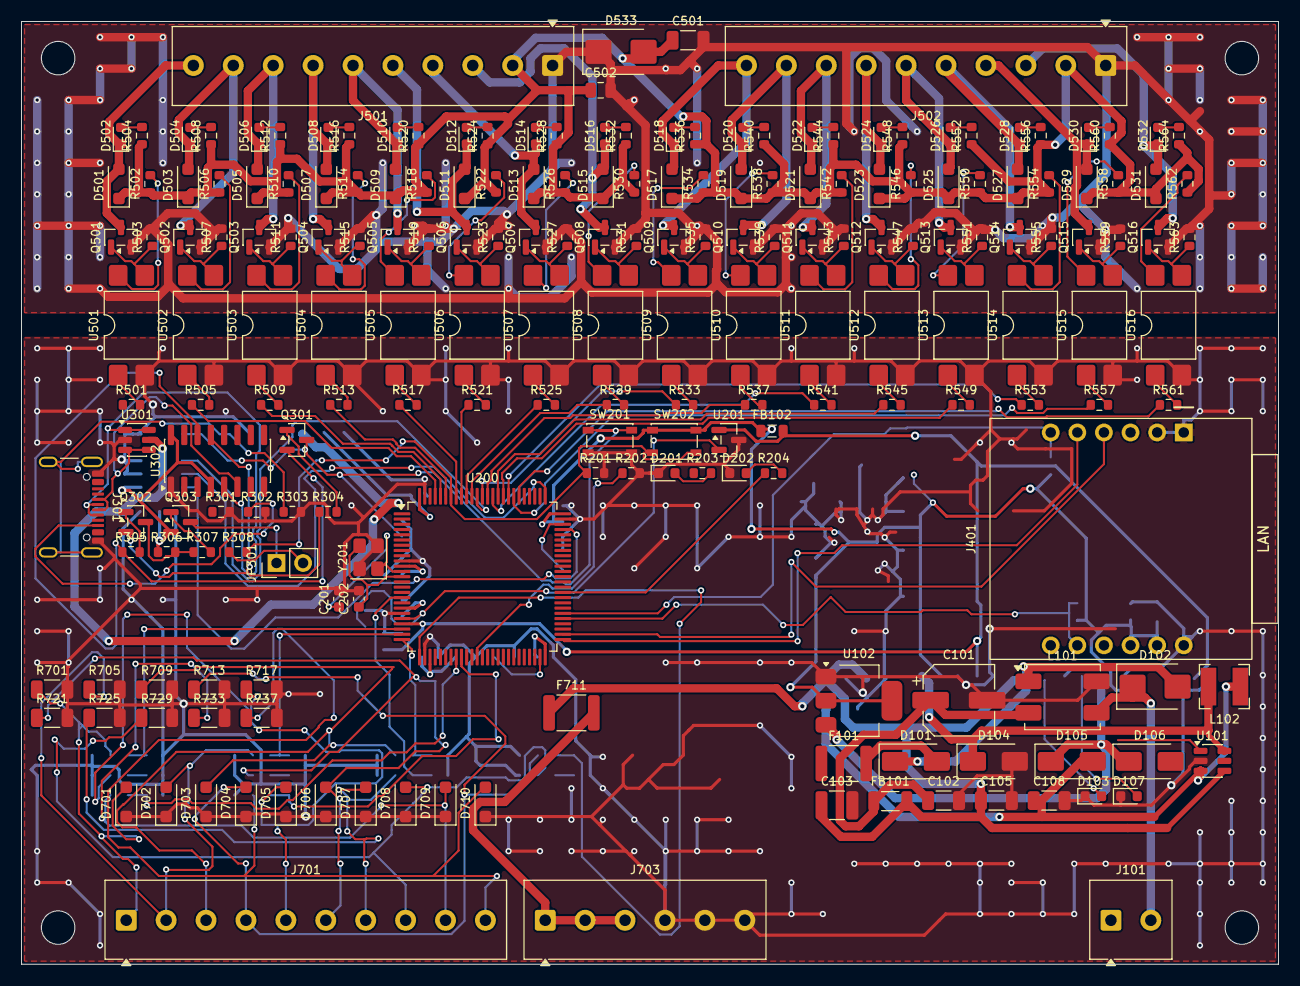
[picture p20: board PLC_STM32_Modbus.kicad_pcb from above]

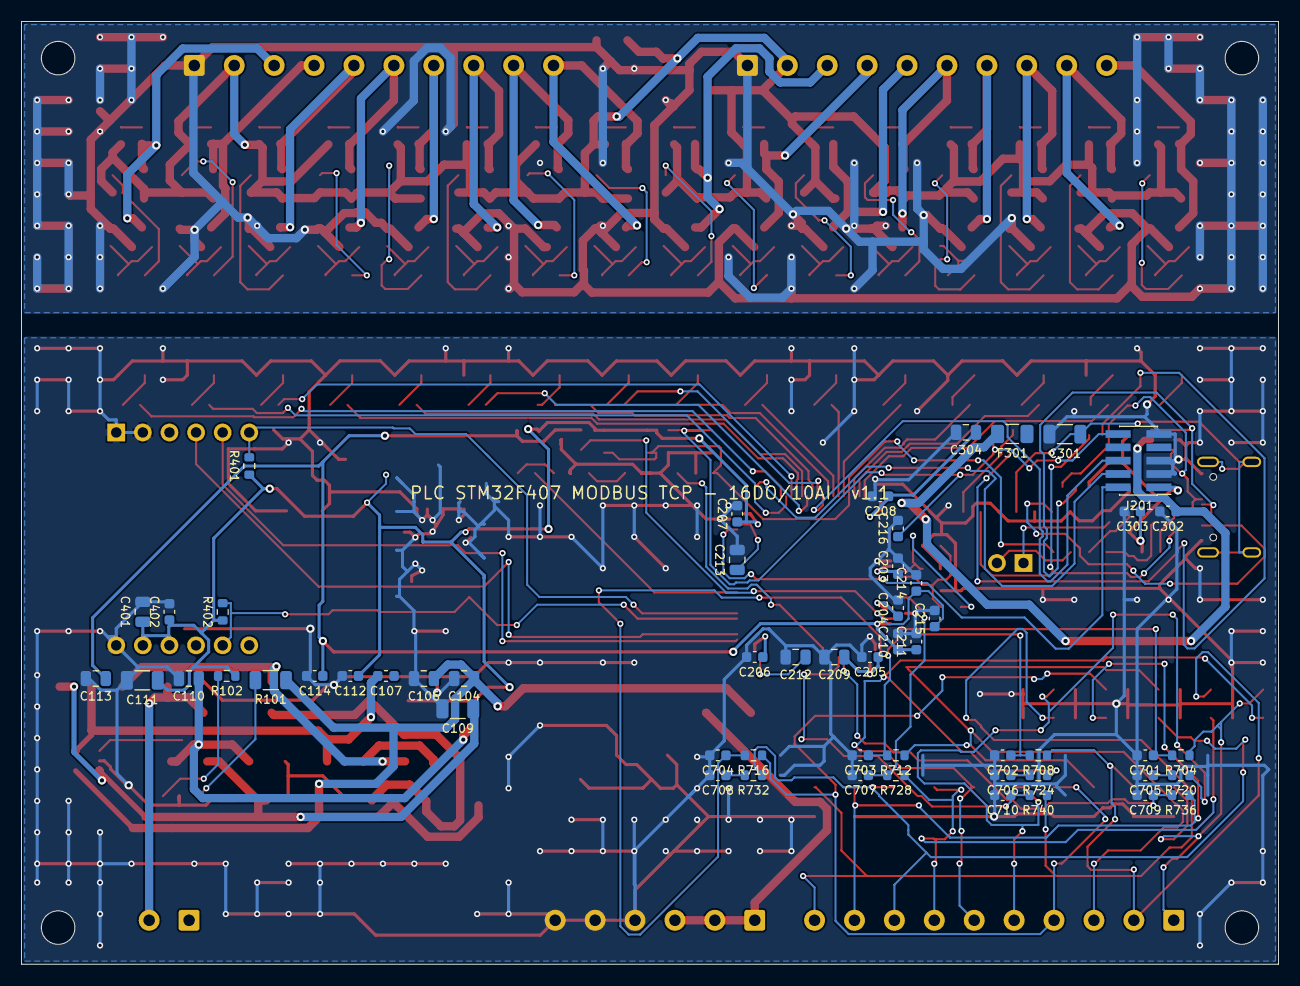
[picture p21: board PLC_STM32_Modbus.kicad_pcb from below]

Board: 2 copper layers, 120.0 x 90.0 mm, 264 parts (55 on the bottom side), 172 nets.

Other parts of the board:
H1, H2, H3, H4: MountingHole_3.2mm_M3
