danhmanu/PLC-STM32F407VET6/(commit log)

2026-10-16 - bỏ các mạch 0-10v, RS485 RTU
2026-10-20 - bỏ các cầu chì thêm mô tả cho từng linh kiên
2026-10-28 - thay w5500 bằng module w5500 lite
